lemwill/QuarkCnc/README.md

# QuarkCnc

Inspired from:
https://github.com/Expatria-Technologies/grblhal_2000_PrintNC

https://github.com/grblHAL

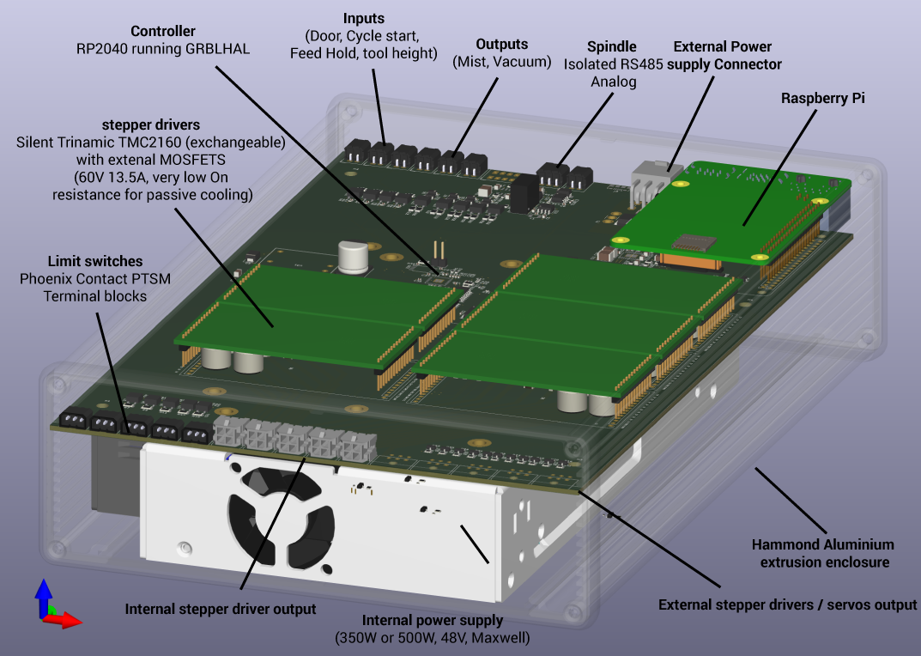
[picture p1: QuarcCnc3D.png]
3D View of QuarkCnc controller
