lemwill/QuarkCnc/QuarkCnc.pdf

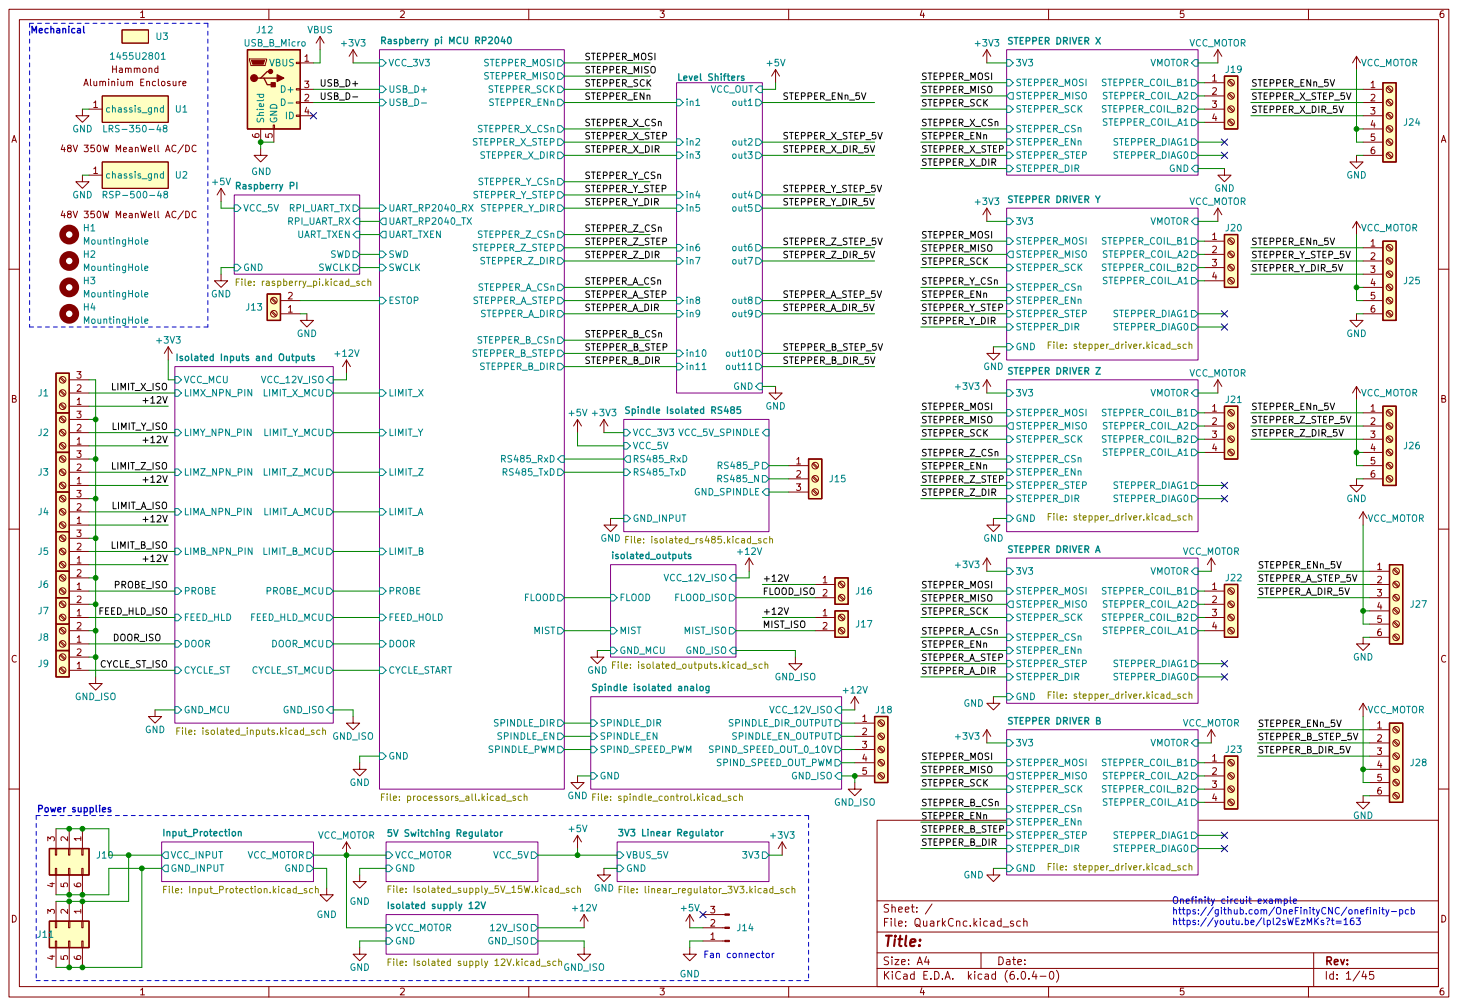
[picture p2: page 1]

Isolated Inputs and Outputs

Onefinity circuit example
https://github.com/OneFinityCNC/onefinity-pcb
https://youtu.be/lpl2sWEzMKs?t=163

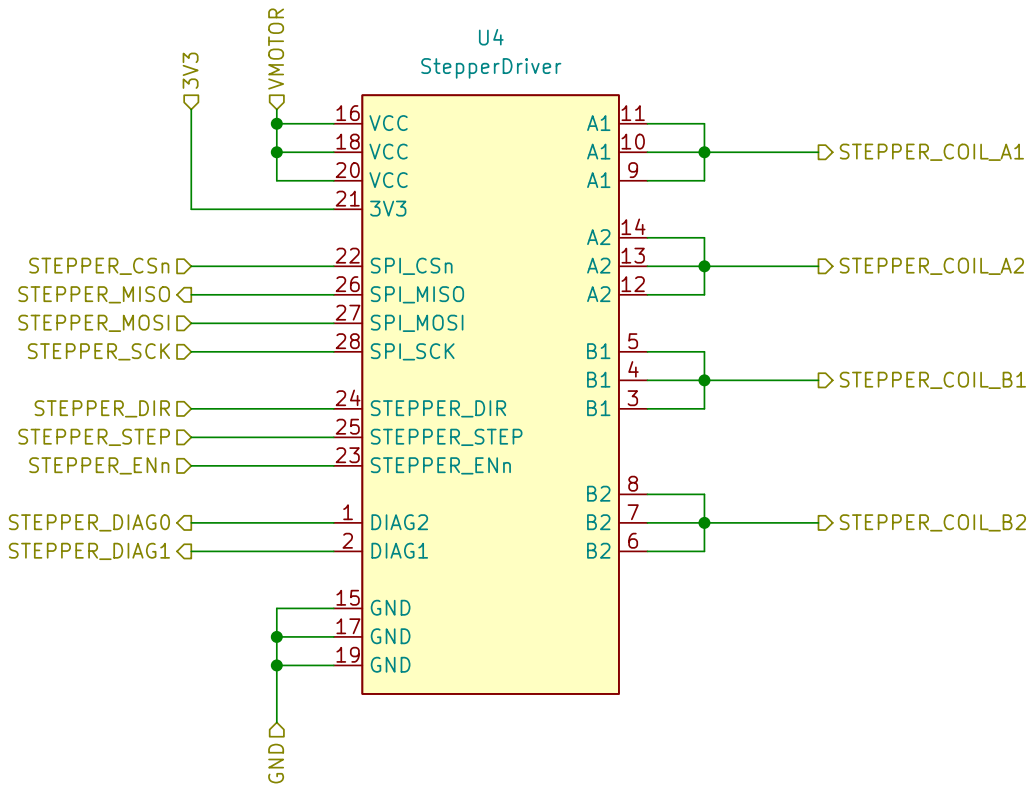
[picture p3: page 2]

File: stepper_driver.kicad_sch Sheet: /STEPPER DRIVER Y/

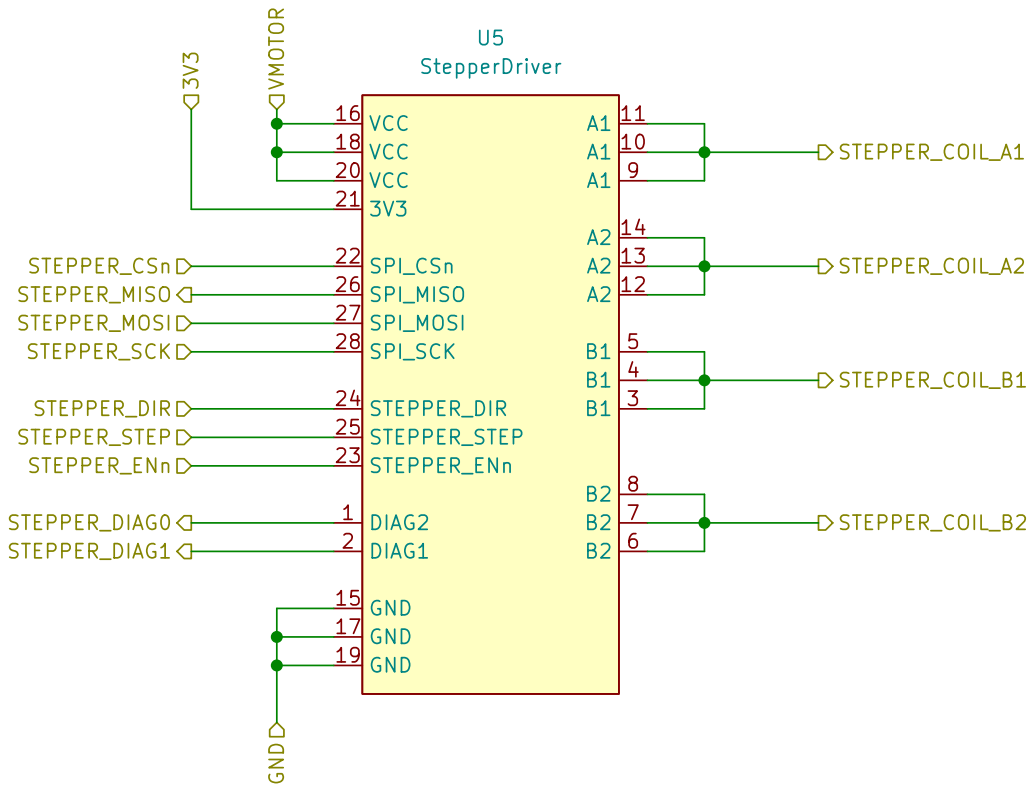
[picture p4: page 3]

File: stepper_driver.kicad_sch Sheet: /STEPPER DRIVER B/

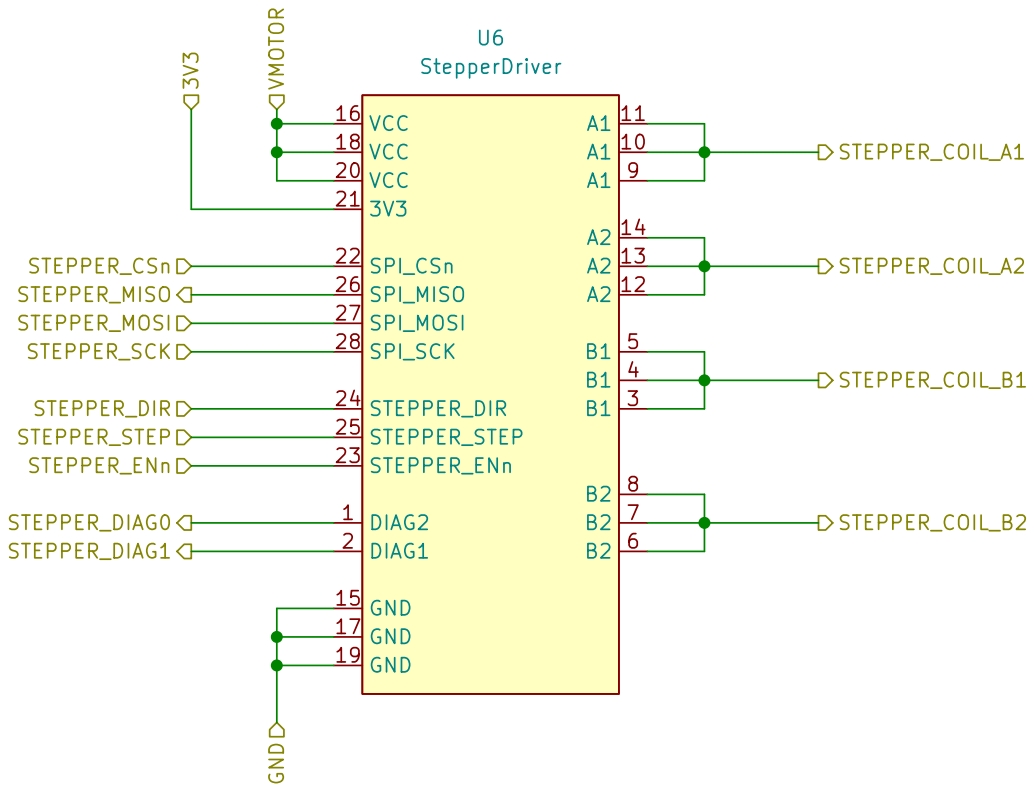
[picture p5: page 4]

File: stepper_driver.kicad_sch Sheet: /STEPPER DRIVER X/

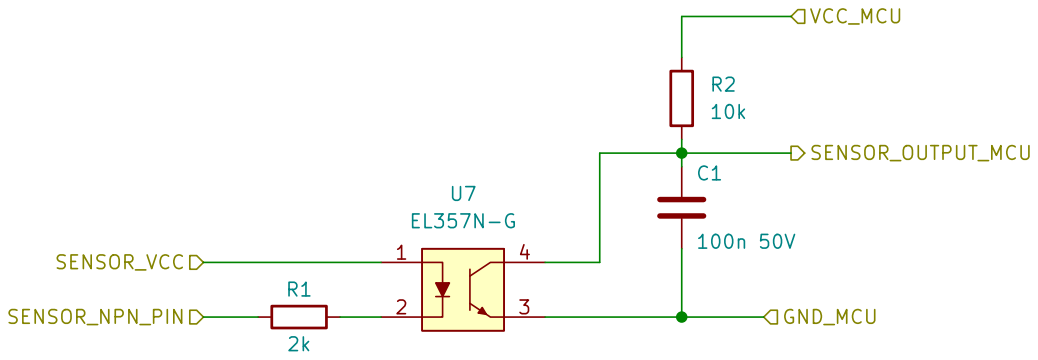
[picture p6: page 5]

Sheet: /Isolated Inputs and Outputs/LIMX/
File: isolated_input.kicad_sch
Id: 8/45 Title:

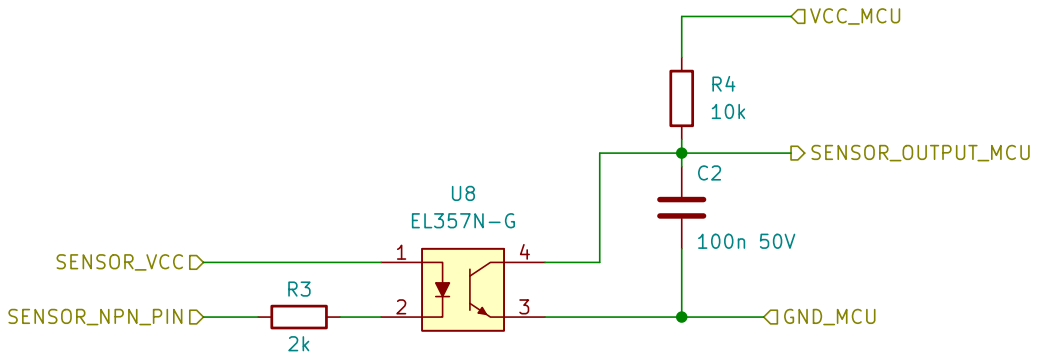
[picture p7: page 6]

Sheet: /Isolated Inputs and Outputs/LIMY/
File: isolated_input.kicad_sch
Id: 9/45 Title:

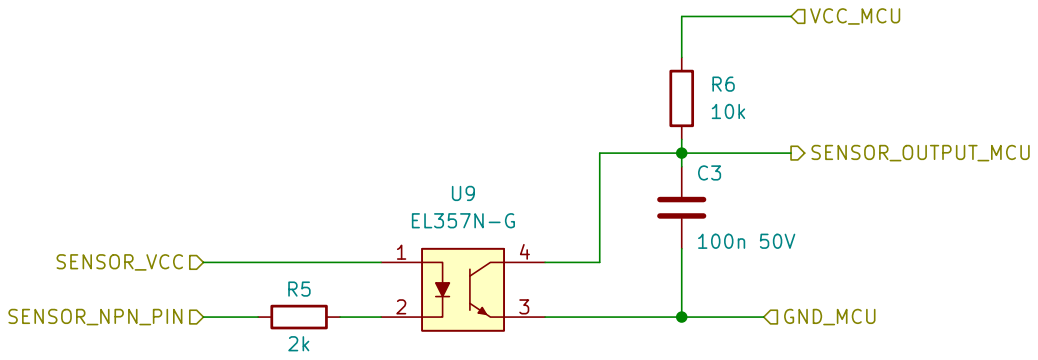
[picture p8: page 7]

Sheet: /Isolated Inputs and Outputs/LIMZ/
File: isolated_input.kicad_sch
Id: 10/45 Title:

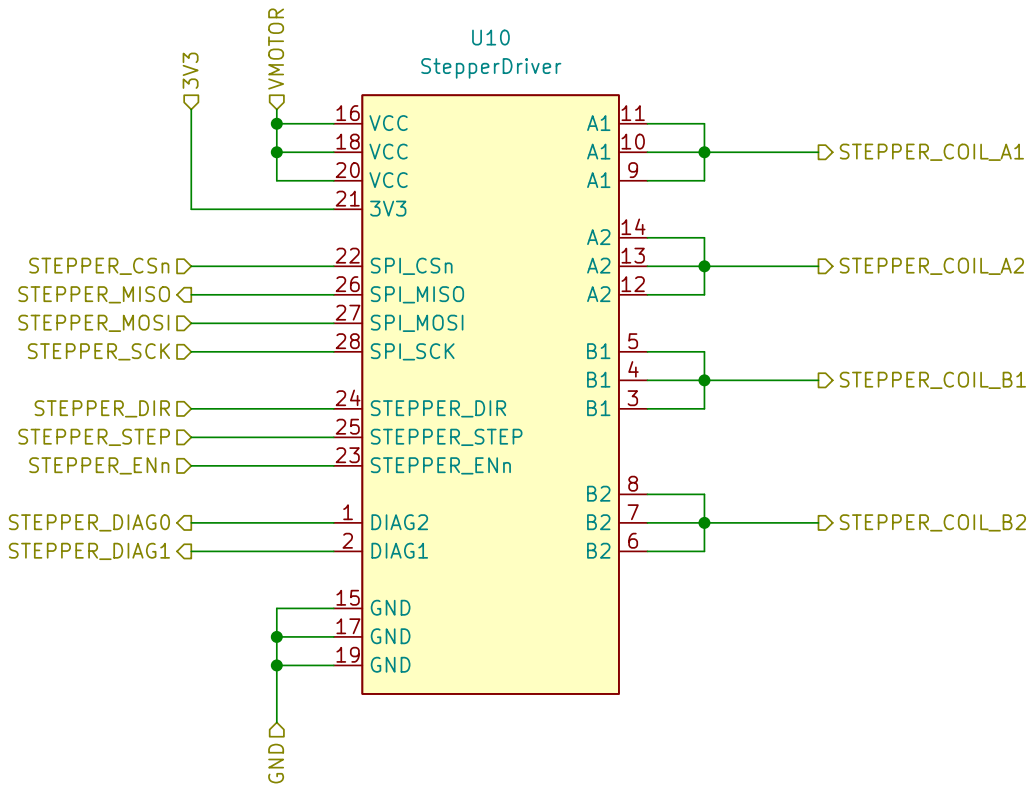
[picture p9: page 8]

File: stepper_driver.kicad_sch Sheet: /STEPPER DRIVER Z/

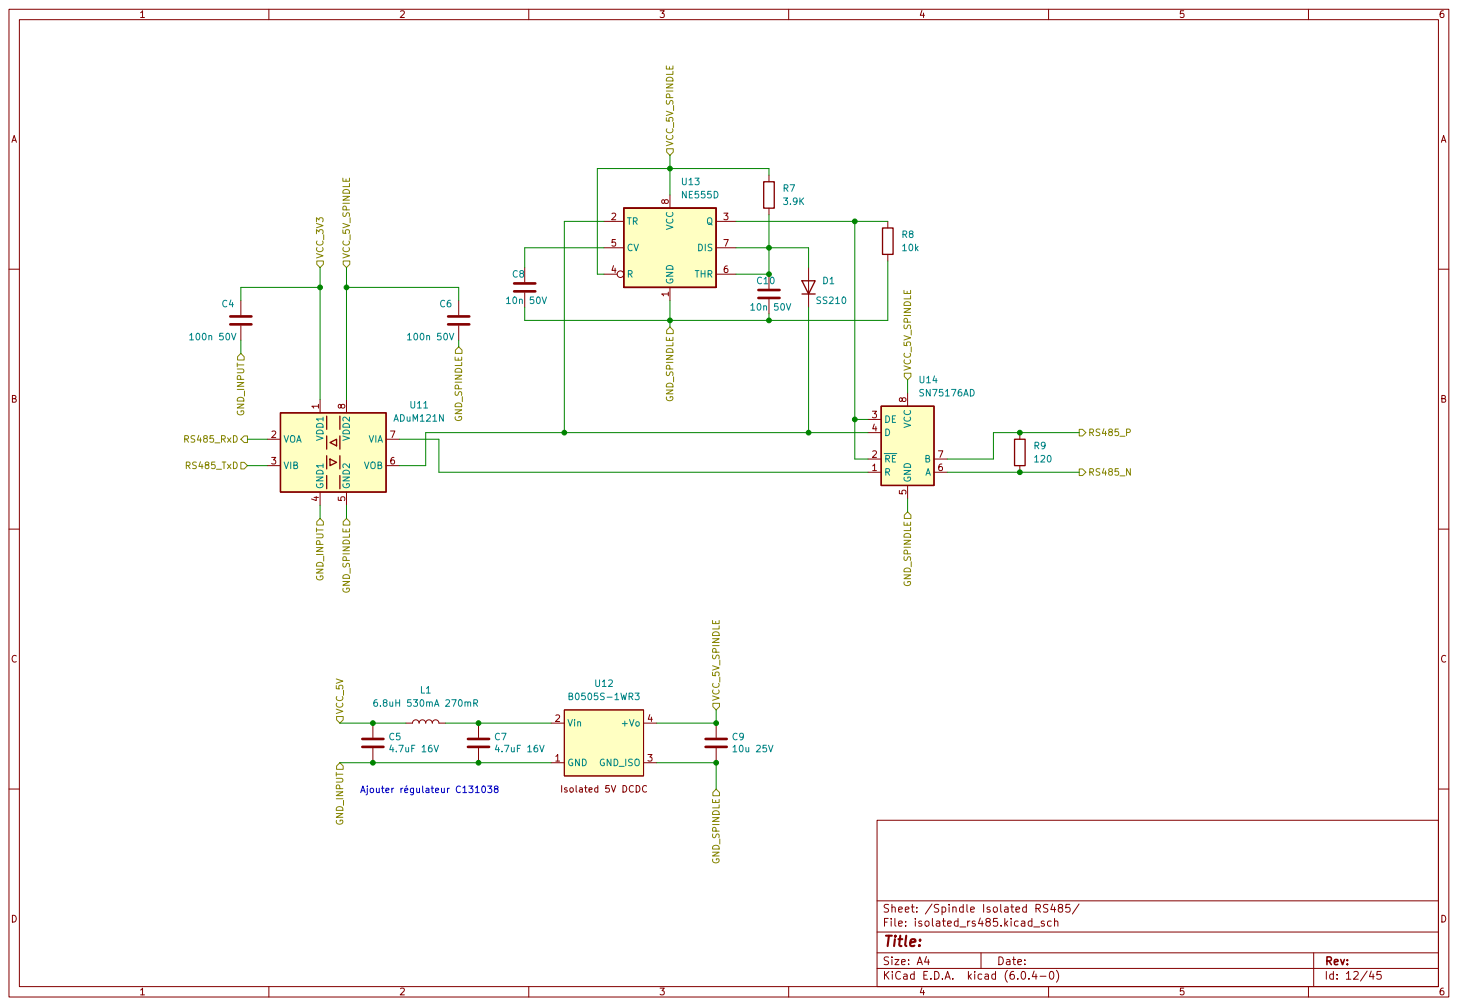
[picture p10: page 9]

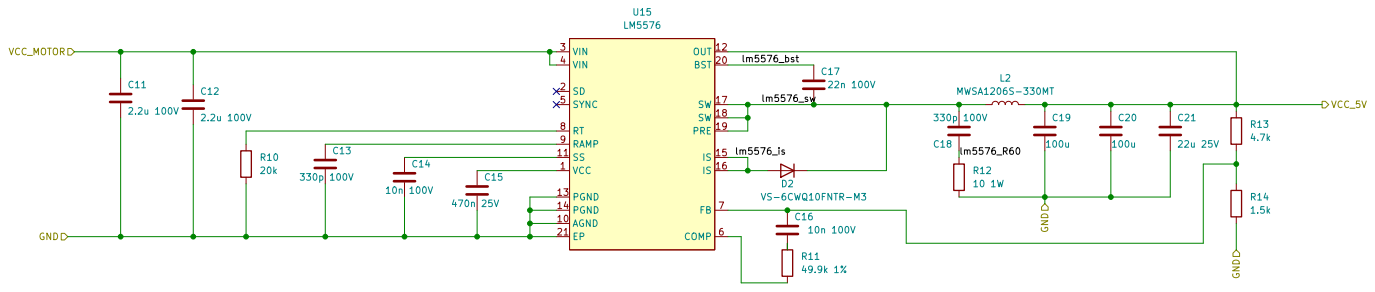
[picture p11: page 10]

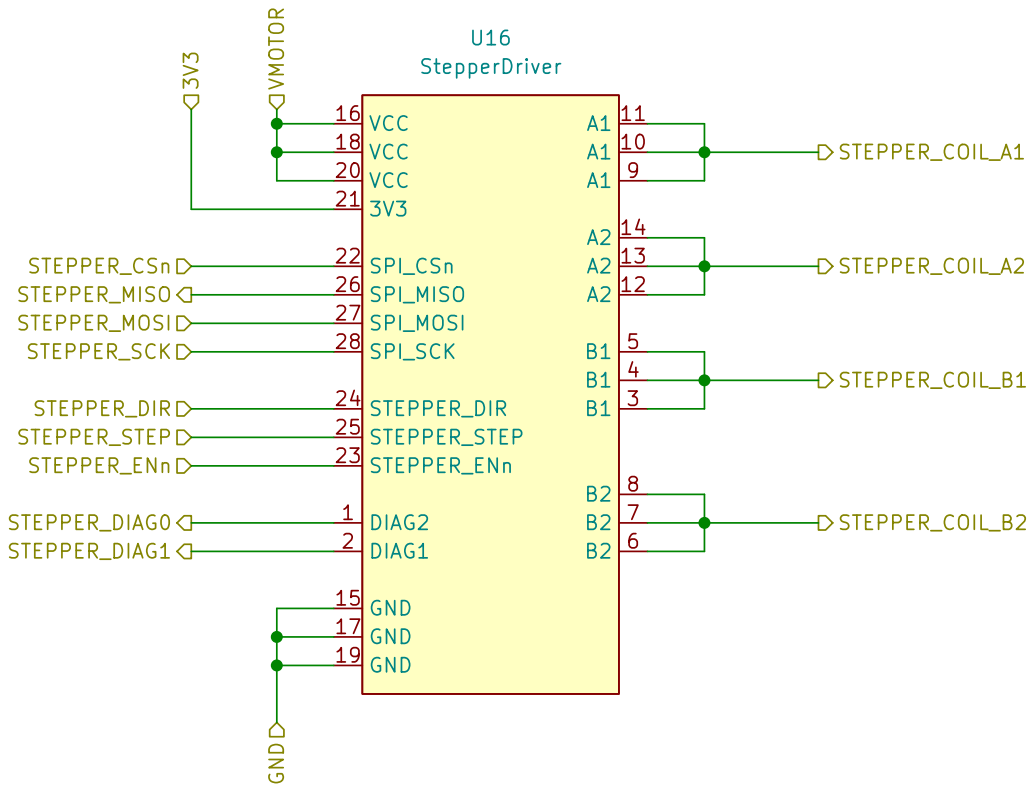
[picture p12: page 11]

File: stepper_driver.kicad_sch Sheet: /STEPPER DRIVER A/

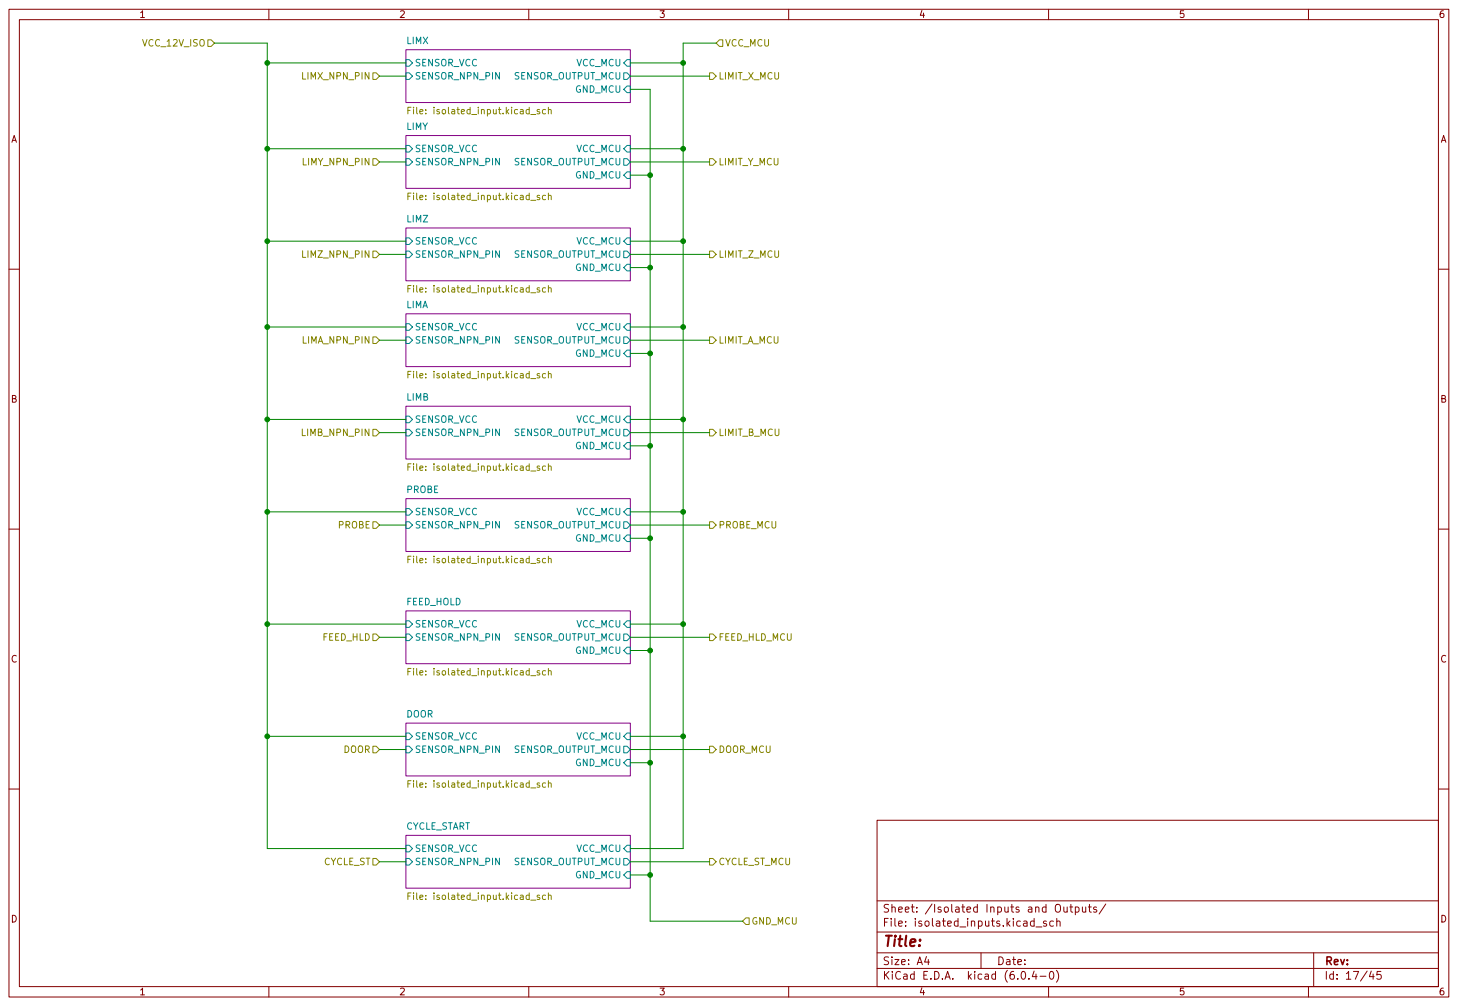
[picture p13: page 12]

DOOR
Sheet: /Isolated Inputs and Outputs/ SENSOR_VCC

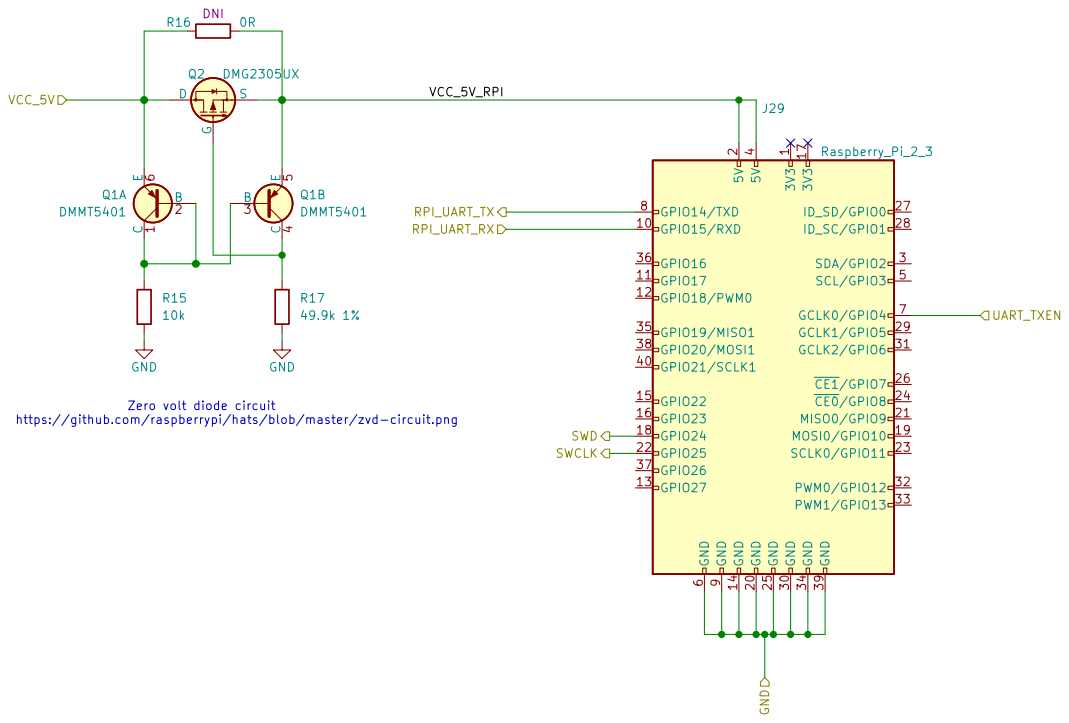
[picture p14: page 13]

VCC_5V_RPI Zero volt diode circuit https://github.com/raspberrypi/hats/blob/master/zvd-circuit.png

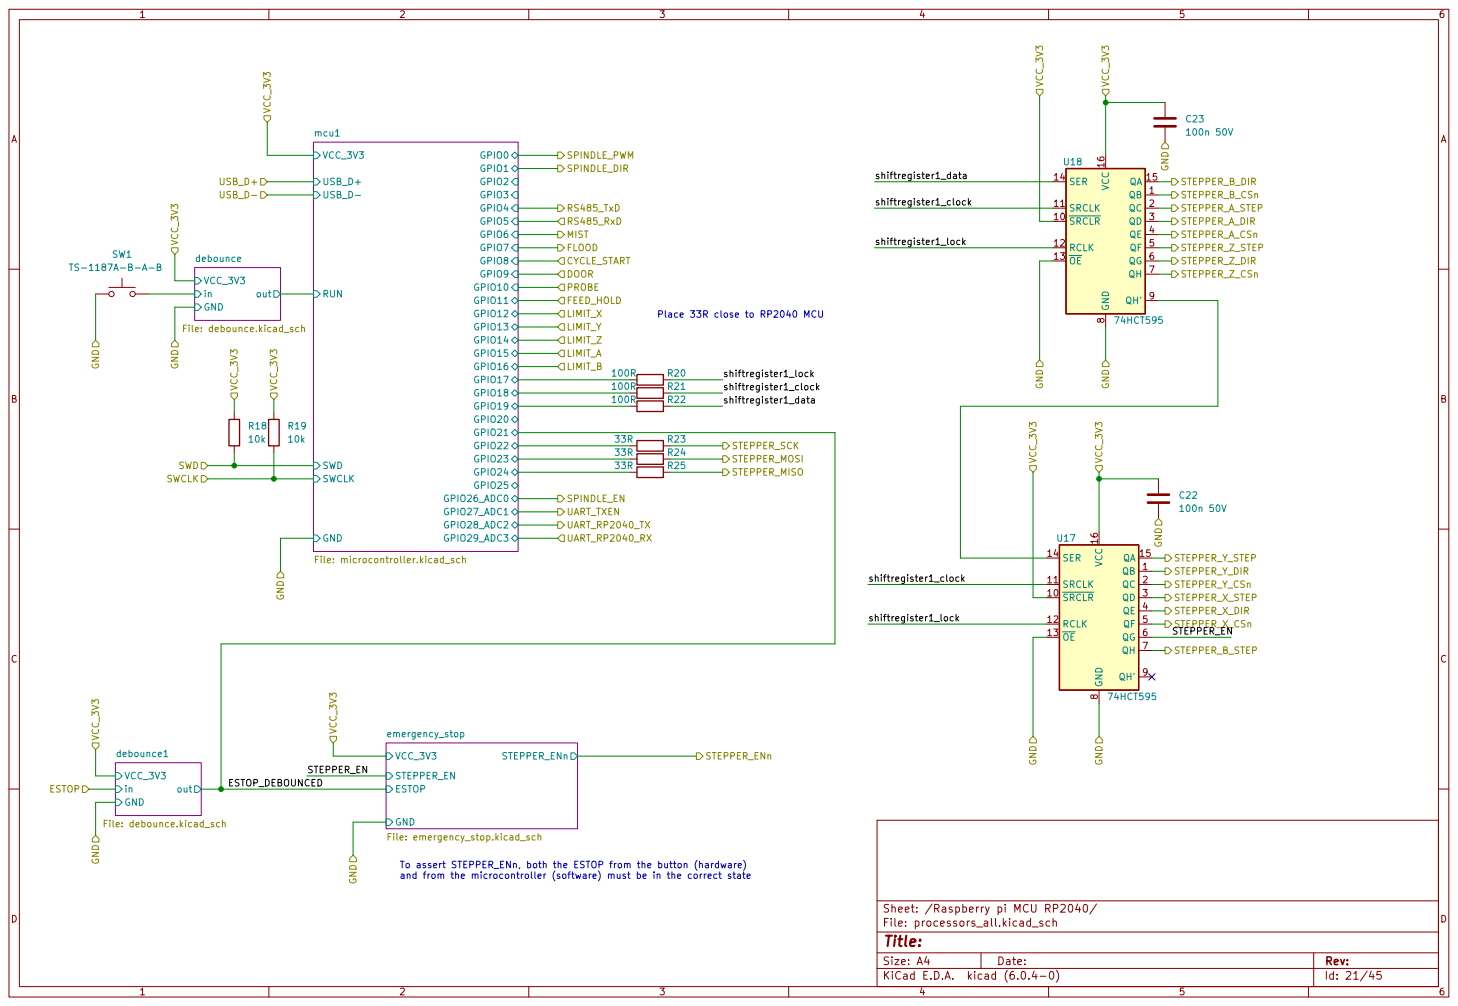
[picture p15: page 14]

Place 33R close to RP2040 MCU

To assert STEPPER_ENn, both the ESTOP from the button (hardware)
and from the microcontroller (software) must be in the correct state

Sheet: /Raspberry pi MCU RP2040/
File: processors_all.kicad_sch
Id: 21/45 Title:

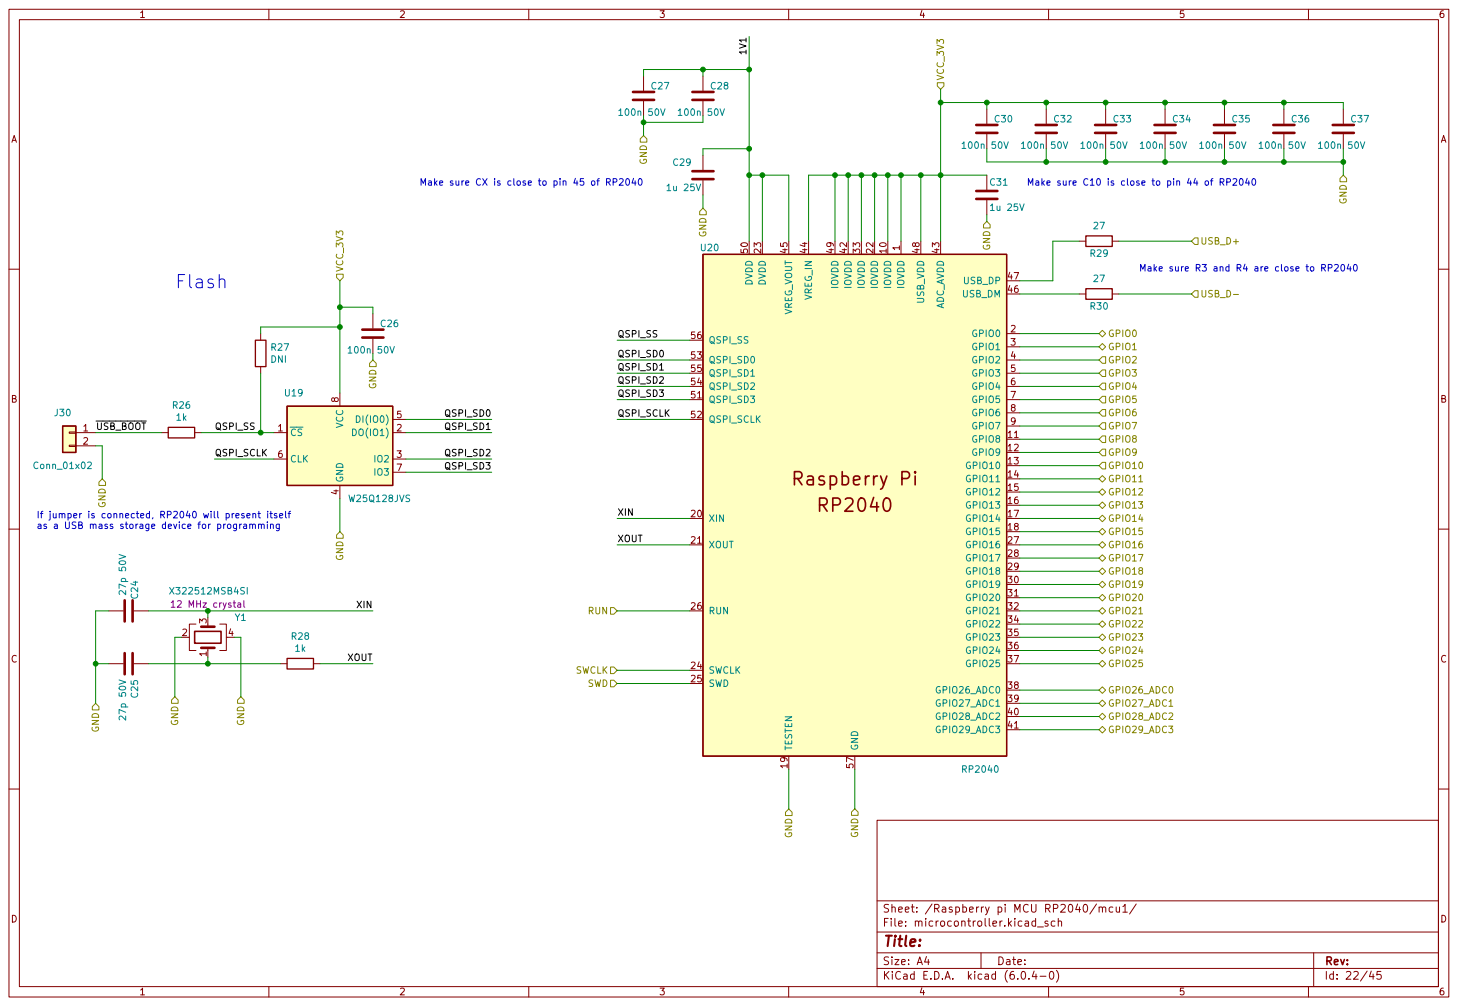
[picture p16: page 15]

1 IOVDD 10 GPIO8 11 GPIO9 12 GPIO10 13 GPIO11 14 GPIO12 15 GPIO13 16 GPIO14 17 GPIO15 18 TESTEN 19 GPIO0 2 XIN 20 XOUT 21 IOVDD 22 DVDD 23 SWCLK 24 SWD 25 RUN 26 GPIO16 27 GPIO17 28 GPIO18 29 GPIO1 3 GPIO19 30 GPIO20 31 GPIO21 32 IOVDD 33 GPIO22 34 GPIO23 35 GPIO24 36 GPIO25 37 GPIO26_ADC0 38 GPIO27_ADC1 39 GPIO2 4 GPIO28_ADC2 40 GPIO29_ADC3 41 IOVDD 42 ADC_AVDD 43 VREG_IN 44 VREG_VOUT 45 USB_DM 46 USB_DP 47 USB_VDD 48 IOVDD 49 GPIO3 5 DVDD 50 QSPI_SD3 51 QSPI_SCLK 52 QSPI_SD0 53 QSPI_SD2 54 QSPI_SD1 55 QSPI_SS 56 GND 57 GPIO4 6 GPIO5 7 GPIO6 8 GPIO7 9 U20 RP2040

If jumper is connected, RP2040 will present itself
as a USB mass storage device for programming

Sheet: /Raspberry pi MCU RP2040/mcu1/
File: microcontroller.kicad_sch
Id: 22/45 Title:

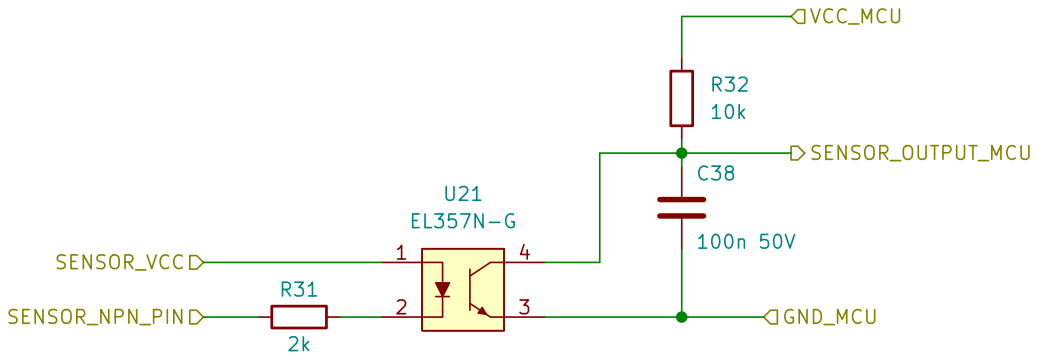
[picture p17: page 16]

Sheet: /Isolated Inputs and Outputs/LIMA/
File: isolated_input.kicad_sch
Id: 25/45 Title:

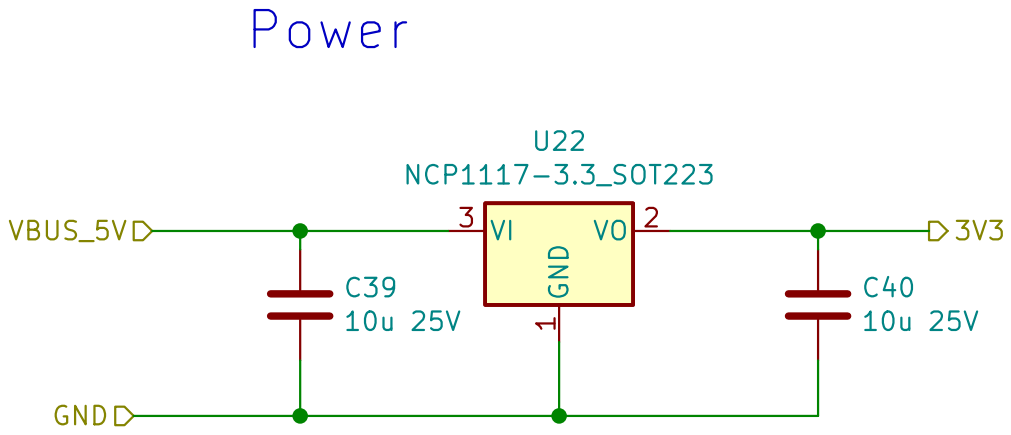
[picture p18: page 17]

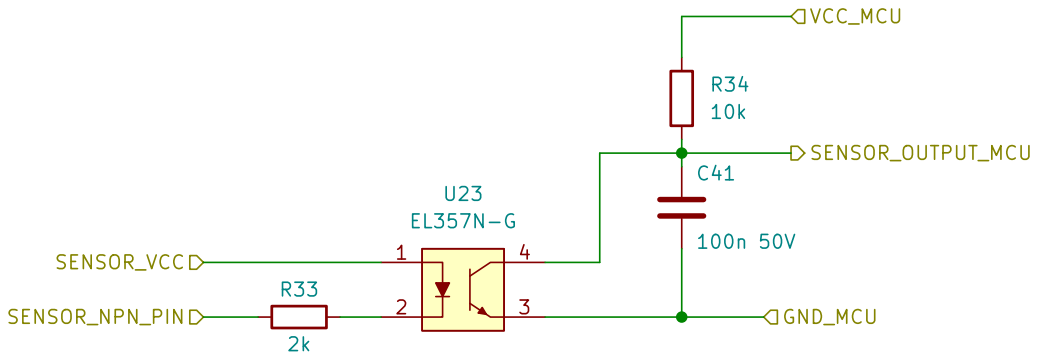
[picture p19: page 18]

Sheet: /Isolated Inputs and Outputs/LIMB/
File: isolated_input.kicad_sch
Id: 27/45 Title:

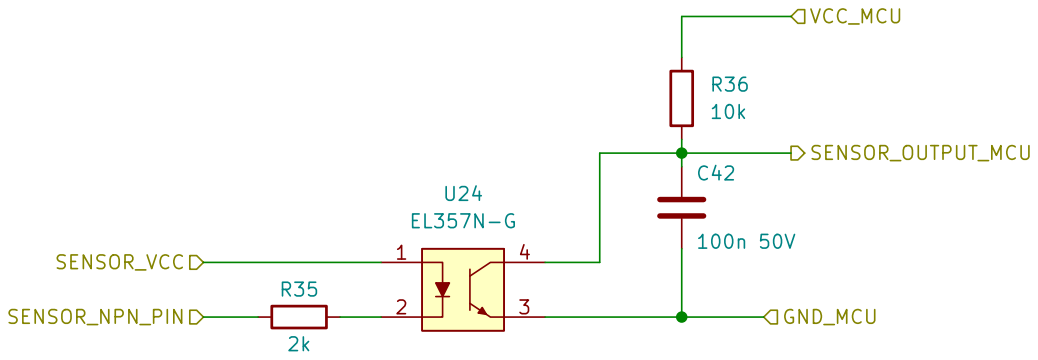
[picture p20: page 19]

Sheet: /Isolated Inputs and Outputs/PROBE/
File: isolated_input.kicad_sch
Id: 27/45 Title:

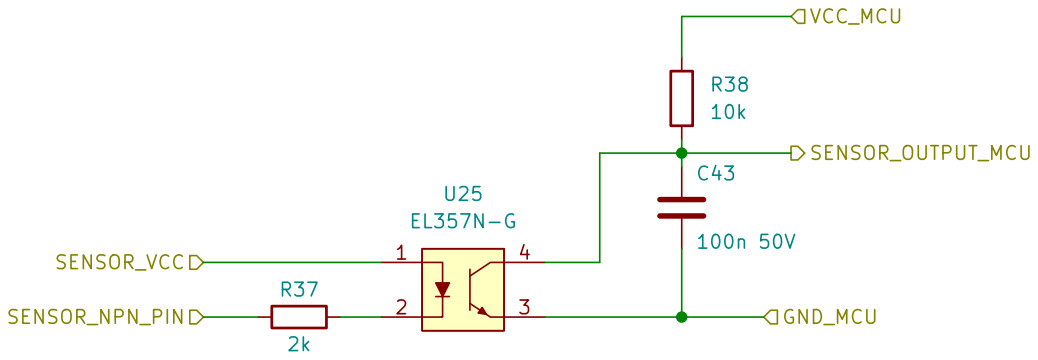
[picture p21: page 20]

Sheet: /Isolated Inputs and Outputs/FEED_HOLD/
File: isolated_input.kicad_sch
Id: 28/45 Title:

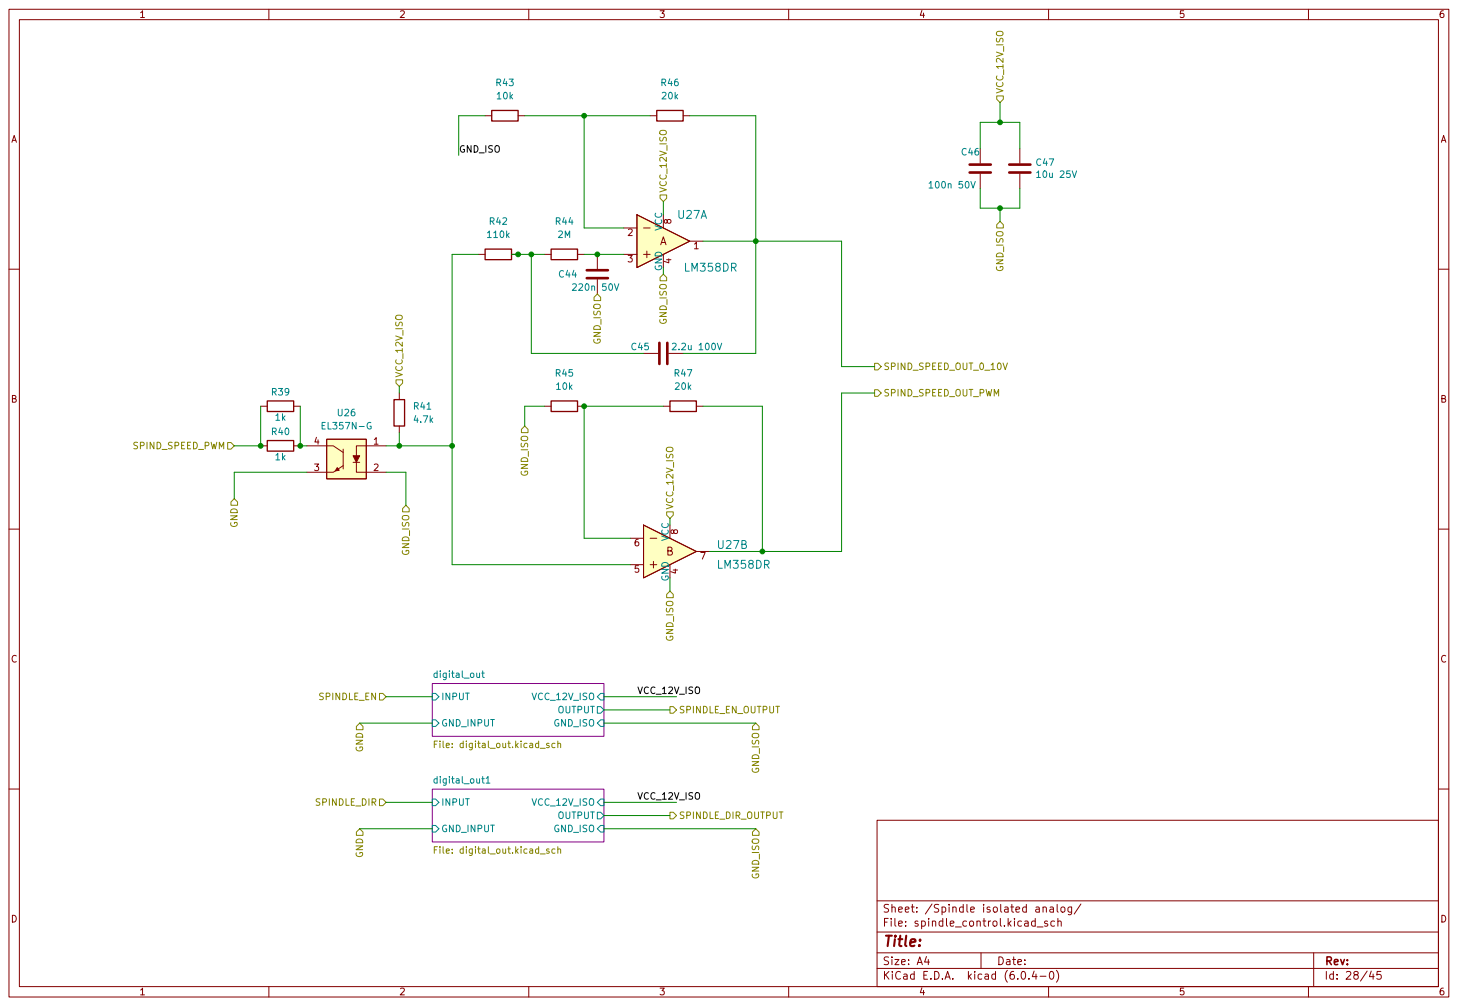
[picture p22: page 21]

OUTPUT
Sheet: /Spindle isolated analog/ GND_ISO

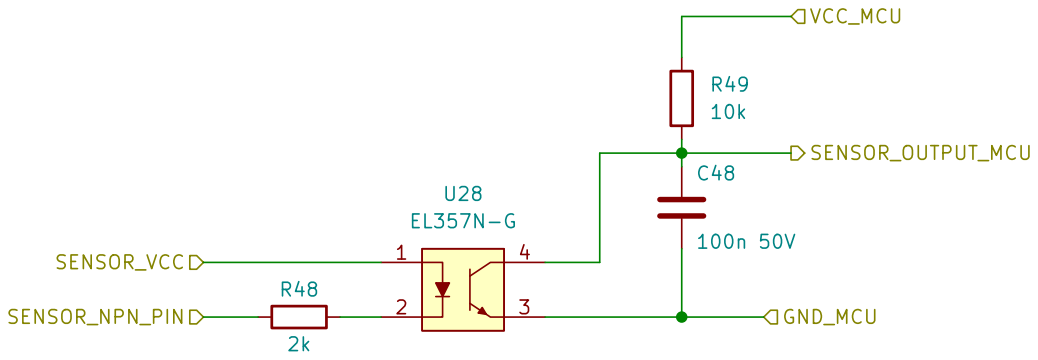
[picture p23: page 22]

Sheet: /Isolated Inputs and Outputs/DOOR/
File: isolated_input.kicad_sch
Id: 29/45 Title:

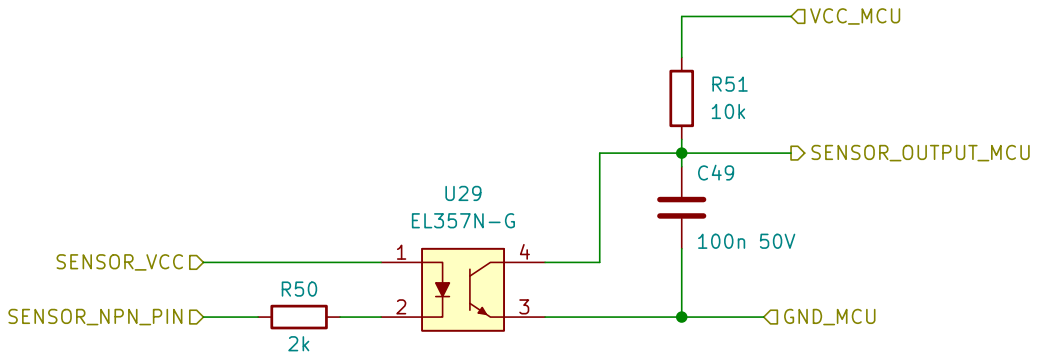
[picture p24: page 23]

Sheet: /Isolated Inputs and Outputs/CYCLE_START/
File: isolated_input.kicad_sch
Id: 30/45 Title:

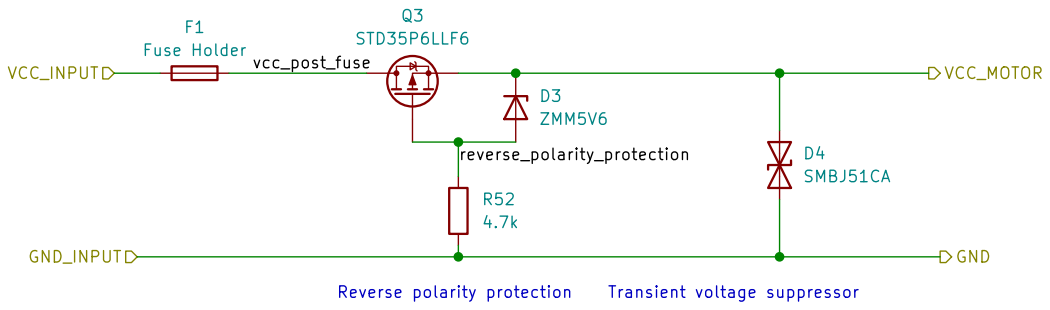
[picture p25: page 24]

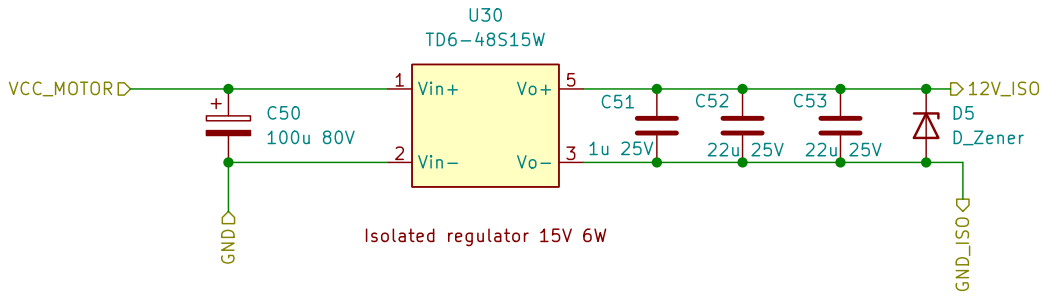
[picture p26: page 25]

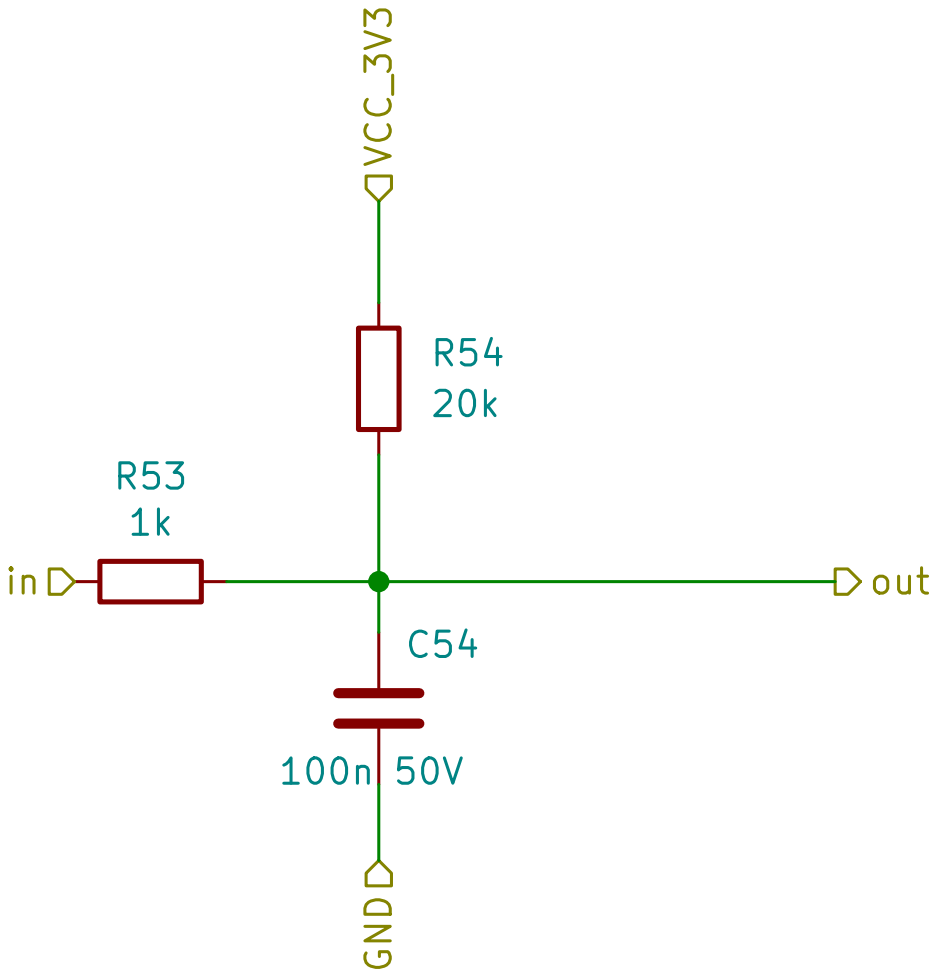
[picture p27: page 26]

Sheet: /Raspberry pi MCU RP2040/debounce1/ C54

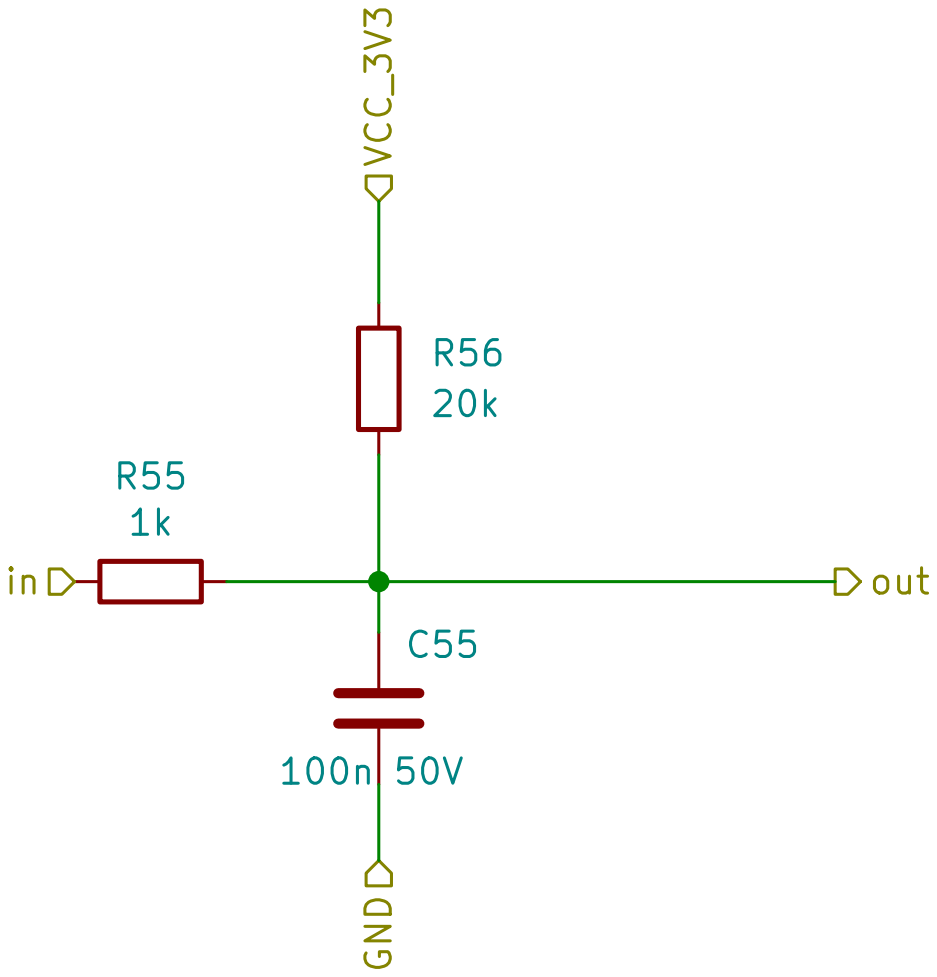
[picture p28: page 27]

Sheet: /Raspberry pi MCU RP2040/debounce/ C55

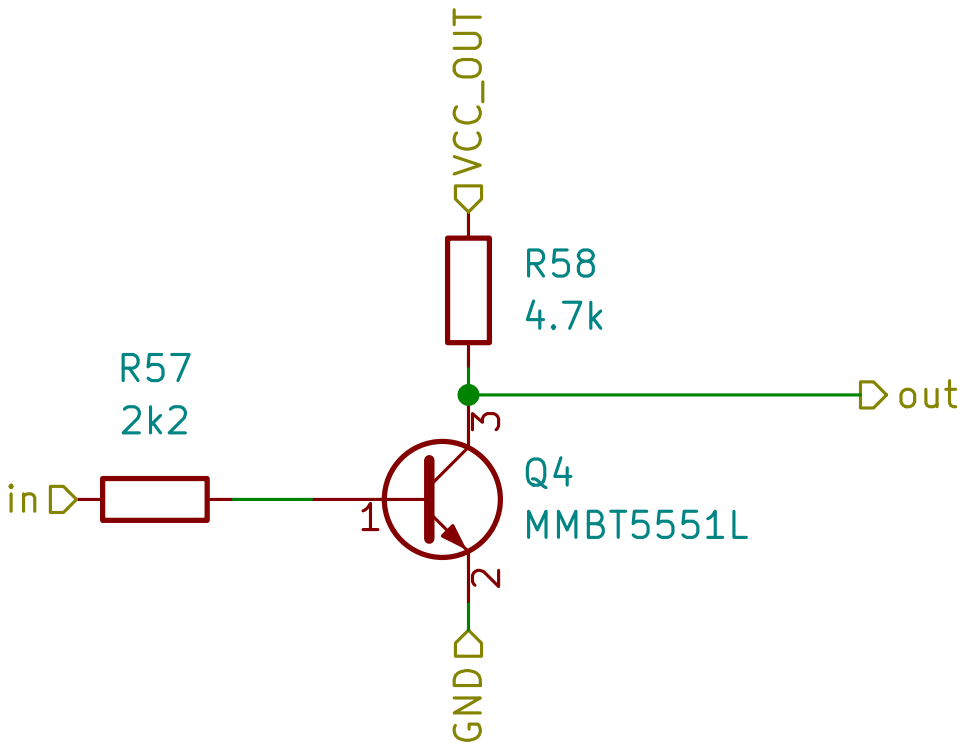
[picture p29: page 28]

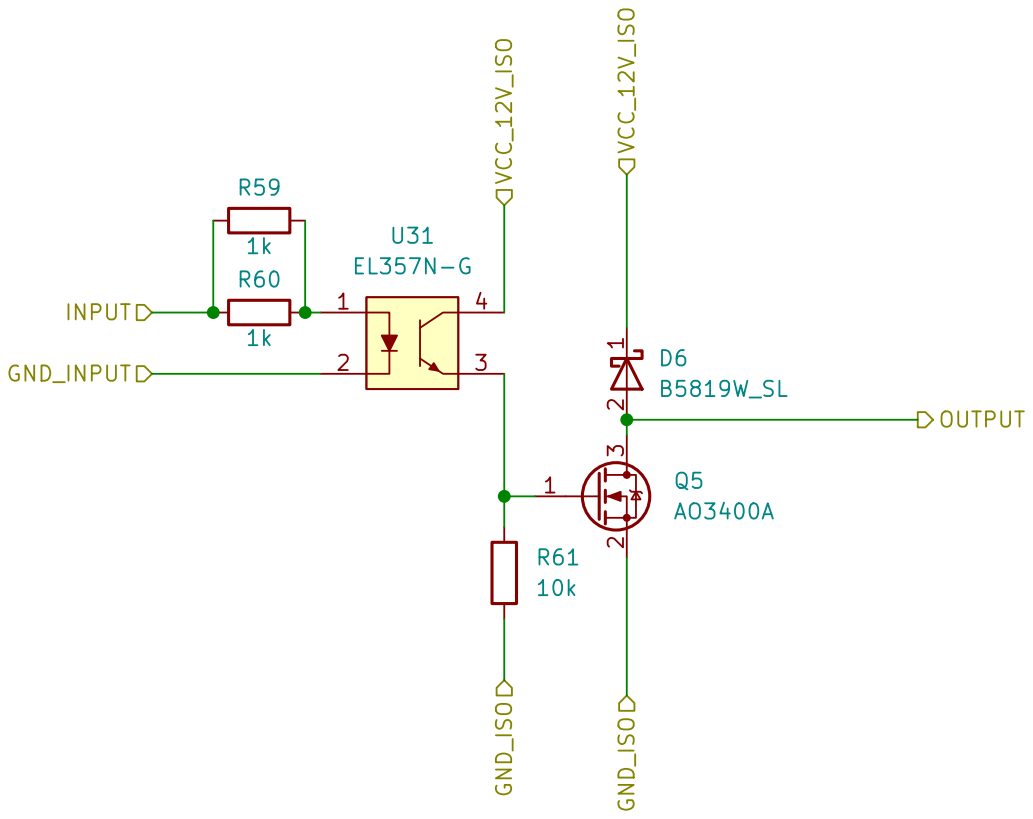
[picture p30: page 29]

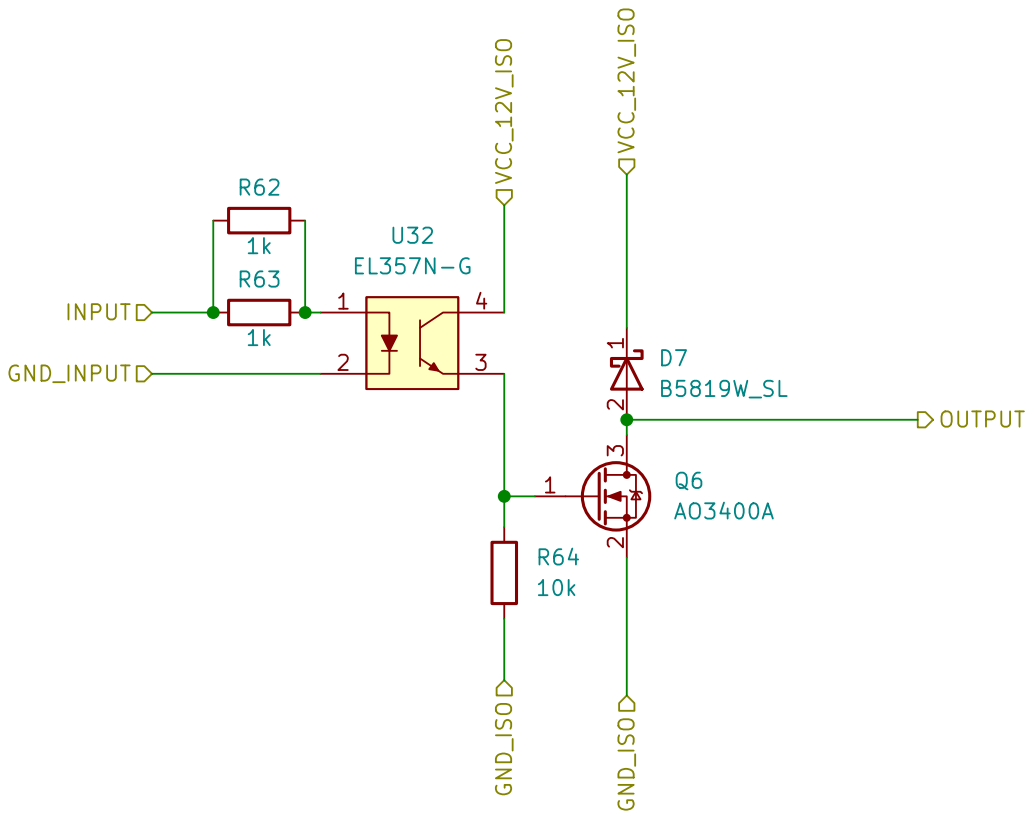
[picture p31: page 30]

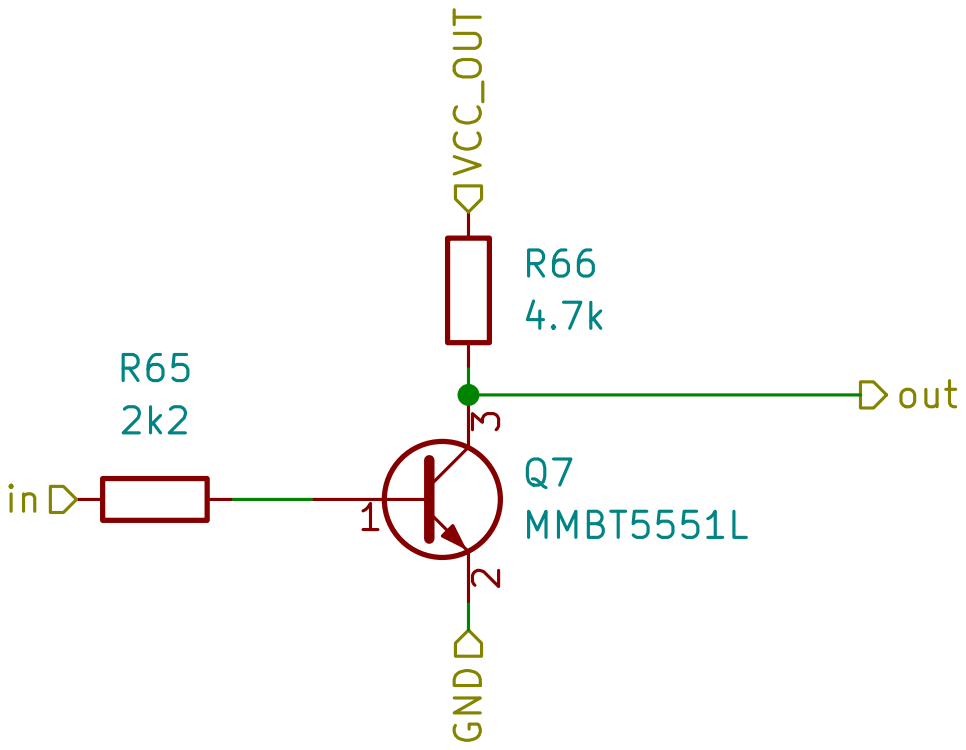
[picture p32: page 31]

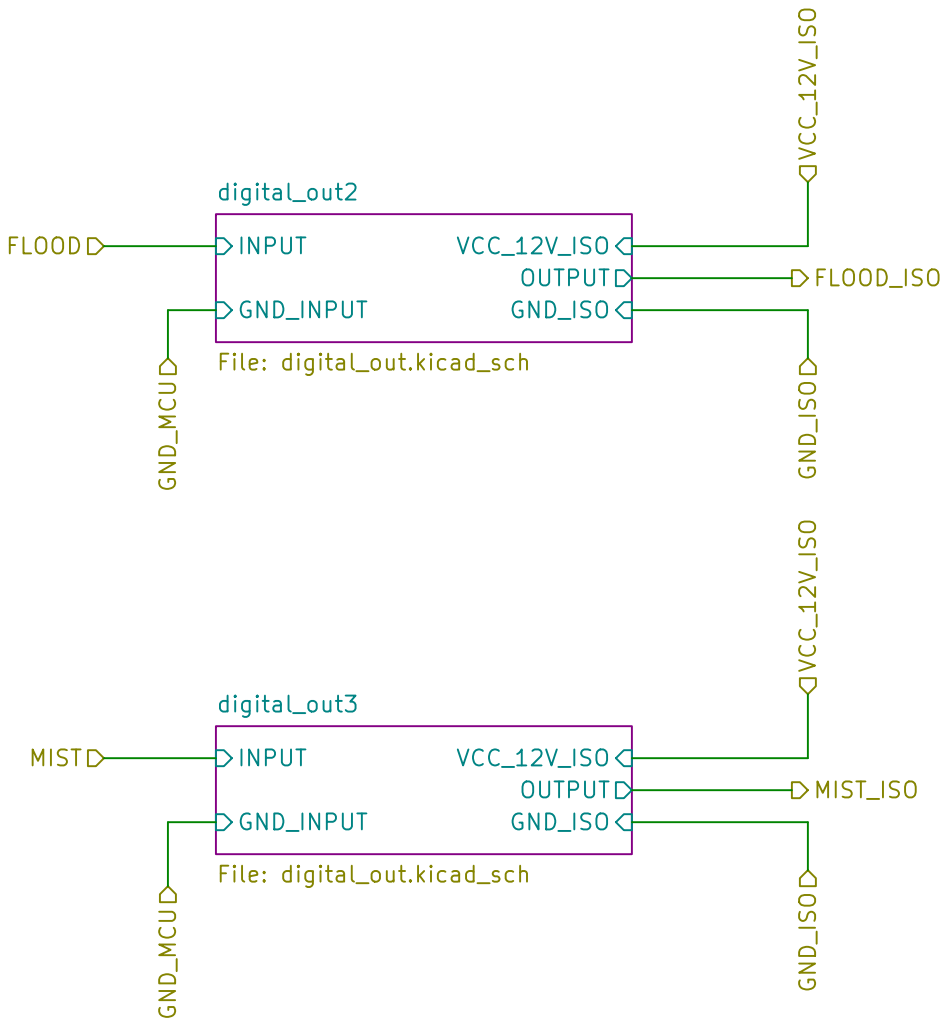
[picture p33: page 32]

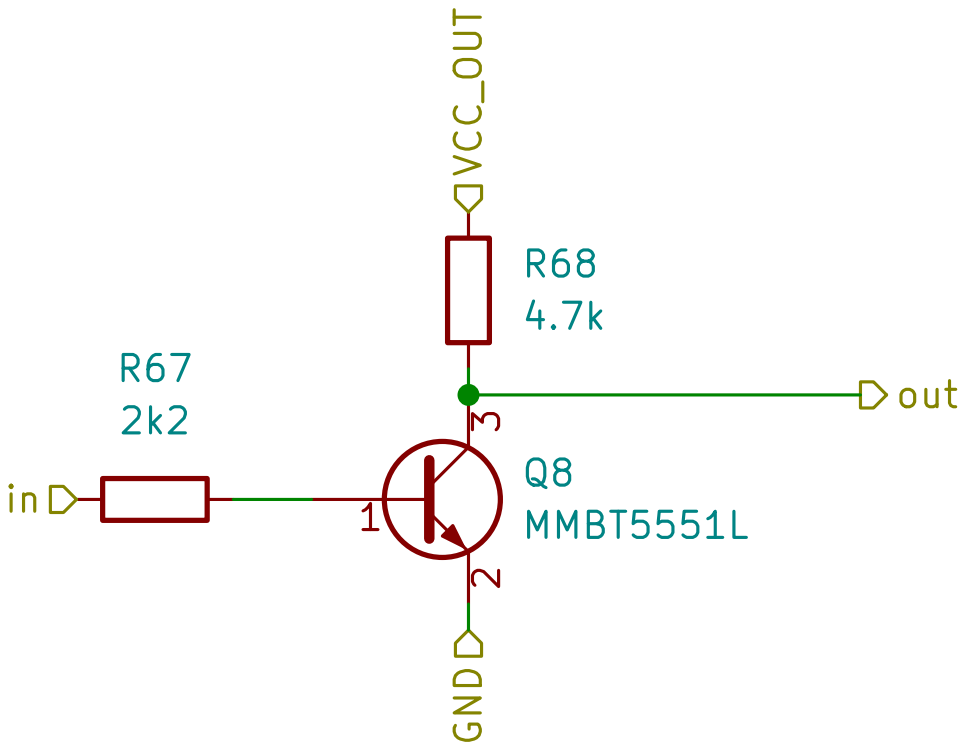
[picture p34: page 33]

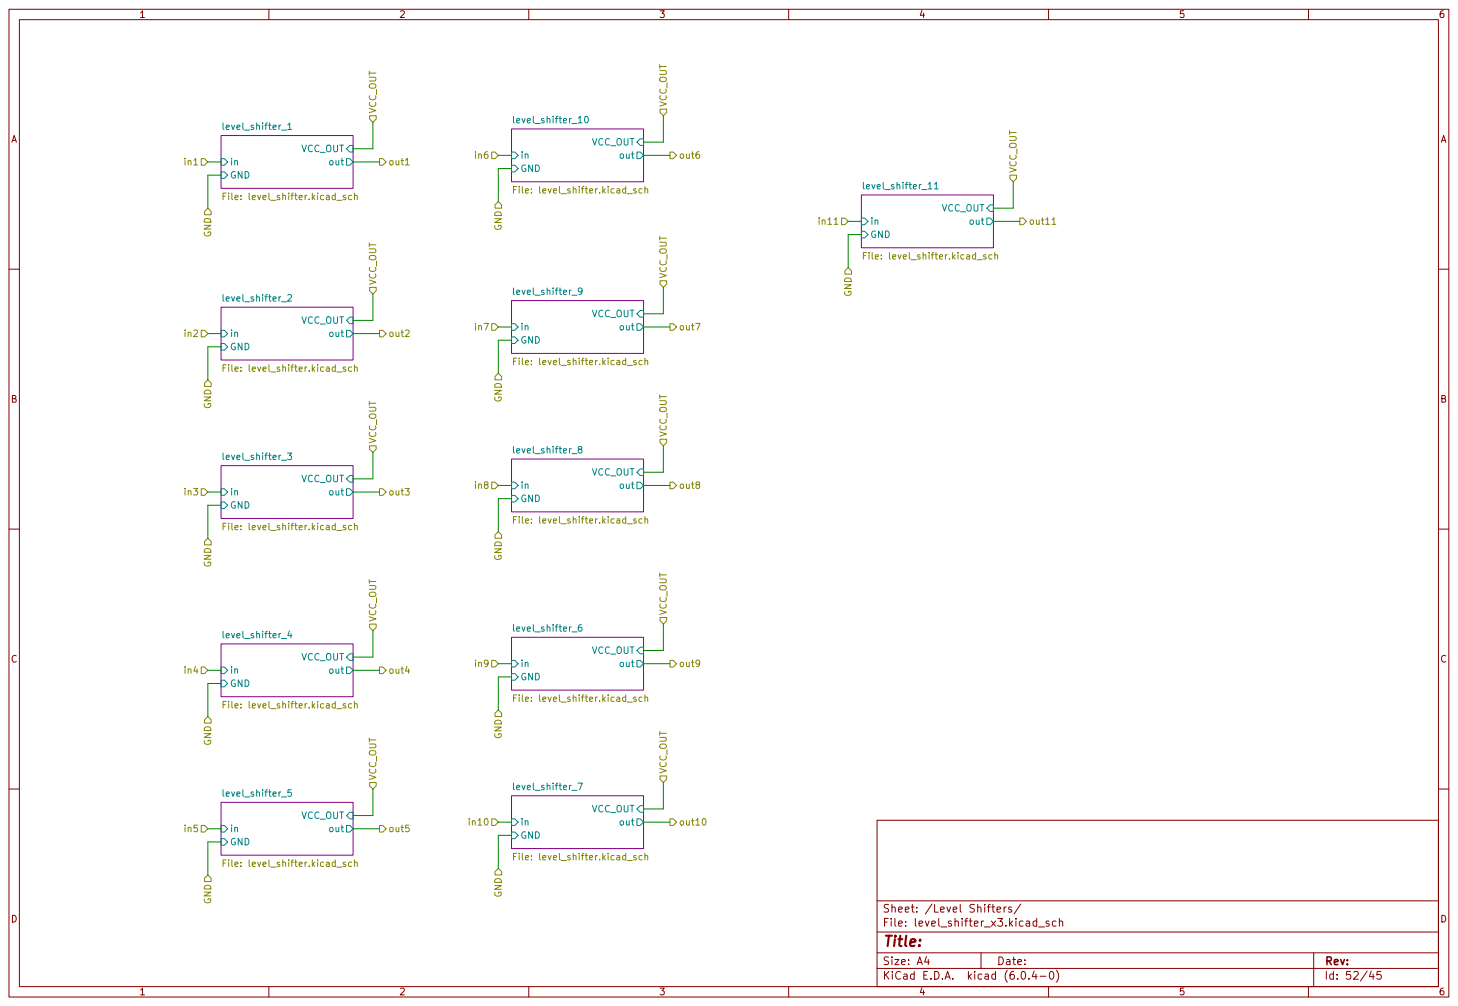
[picture p35: page 34]

File: level_shifter_x3.kicad_sch Sheet: /Level Shifters/ GND

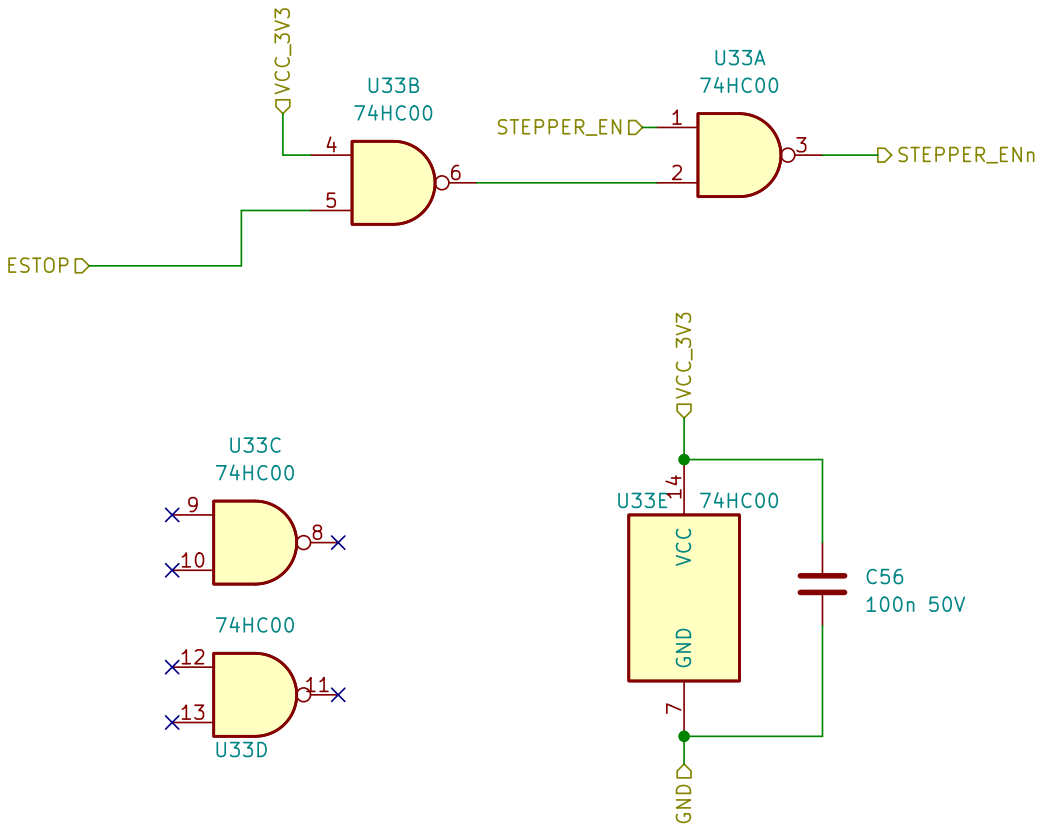
[picture p36: page 35]

Sheet: /Raspberry pi MCU RP2040/emergency_stop/ C56

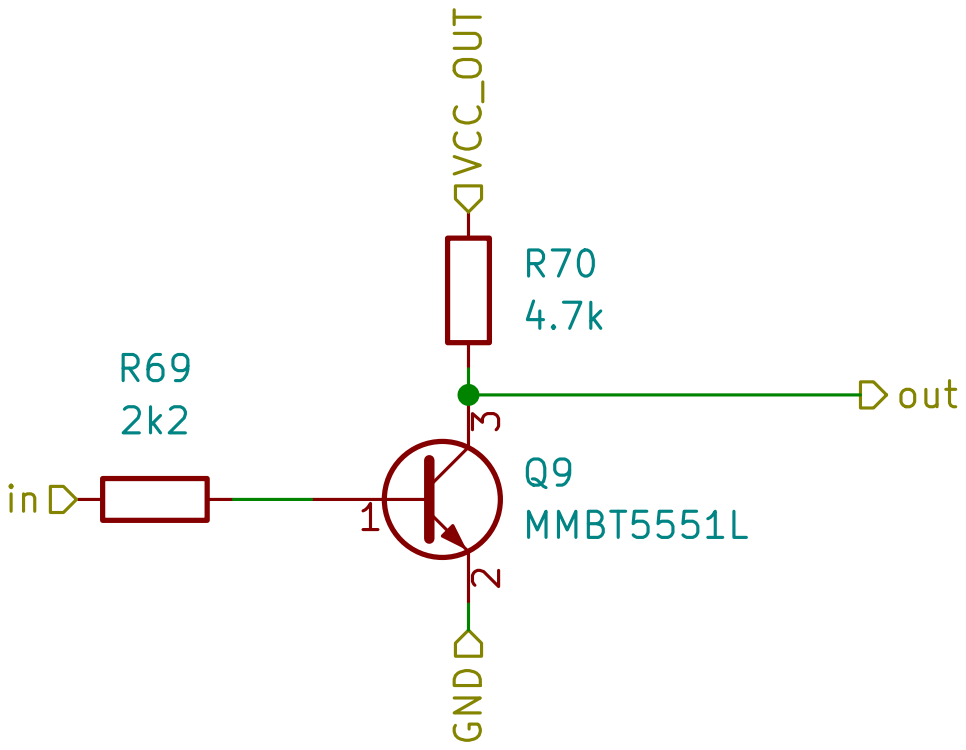
[picture p37: page 36]

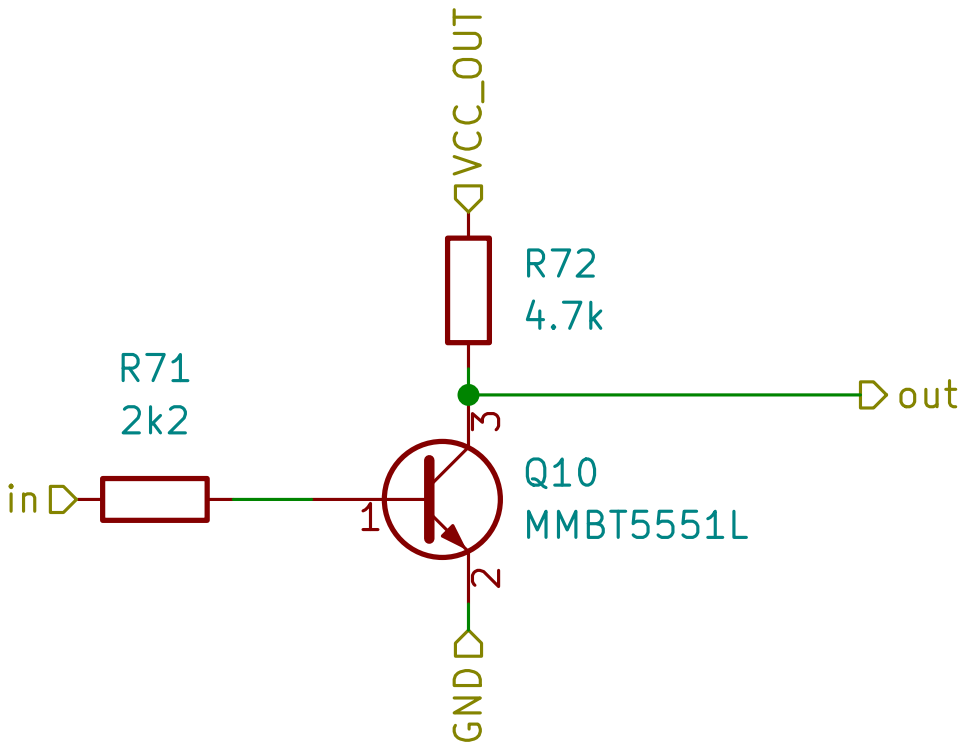
[picture p38: page 37]

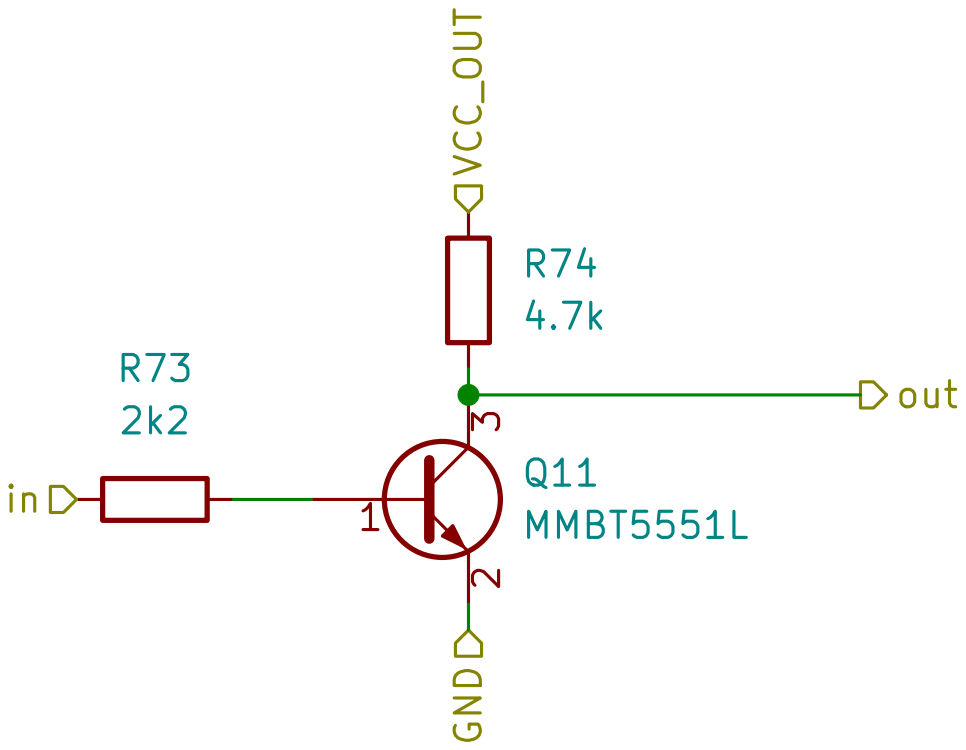
[picture p39: page 38]

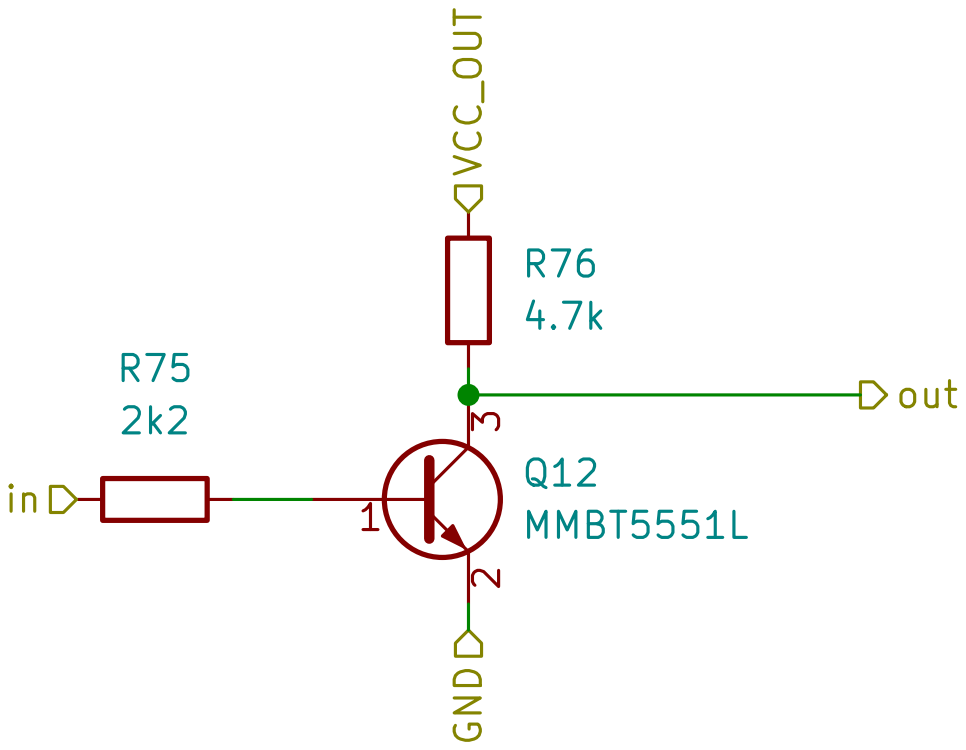
[picture p40: page 39]

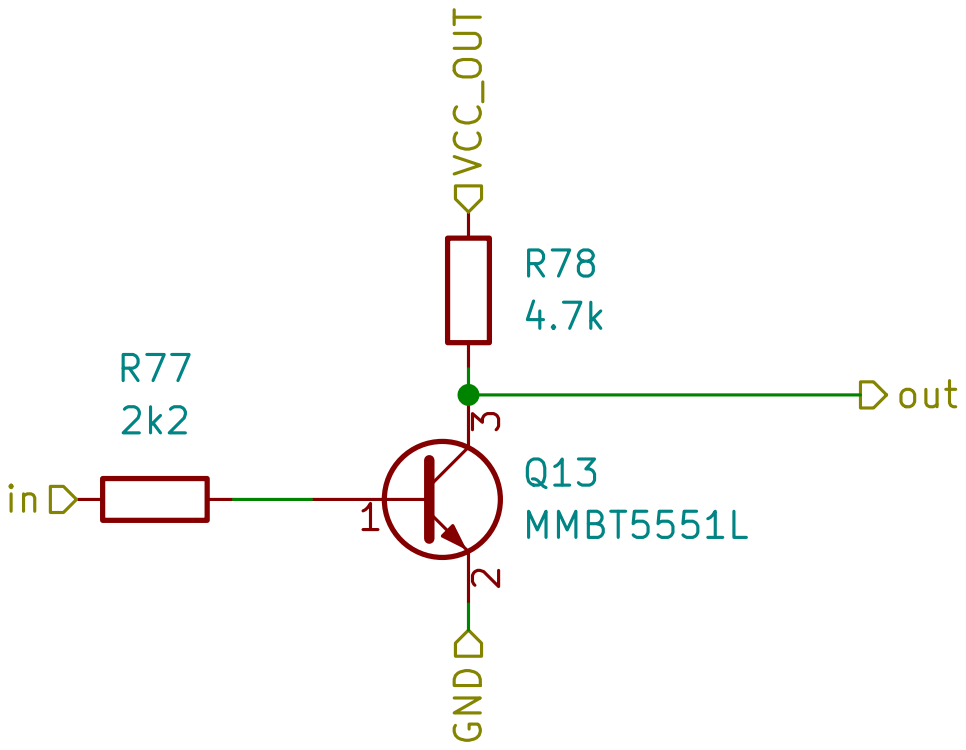
[picture p41: page 40]

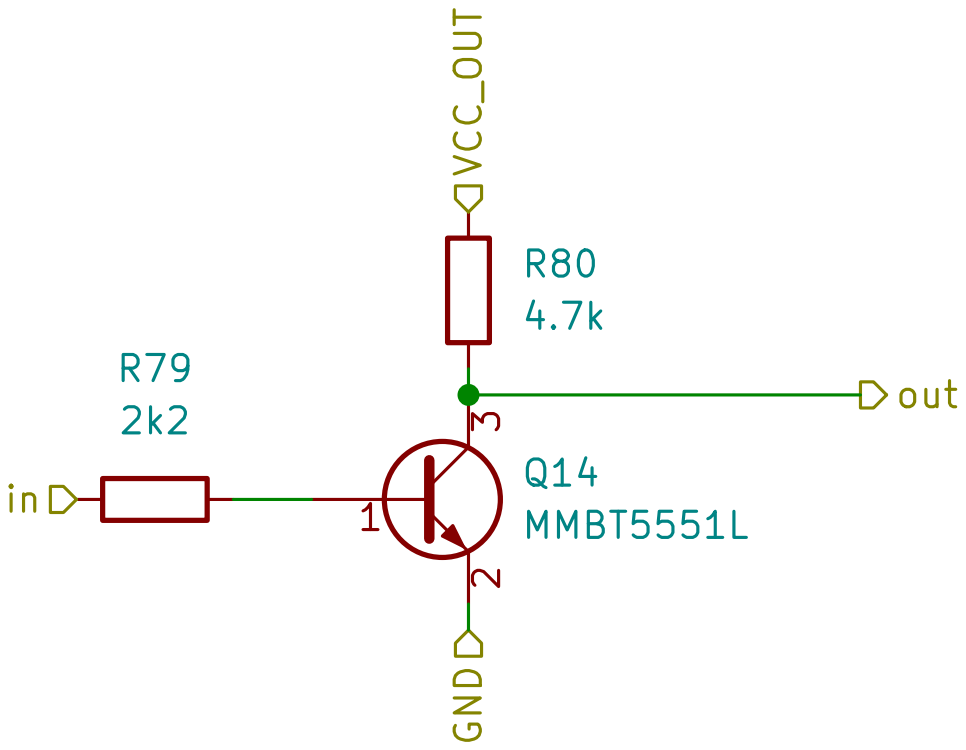
[picture p42: page 41]

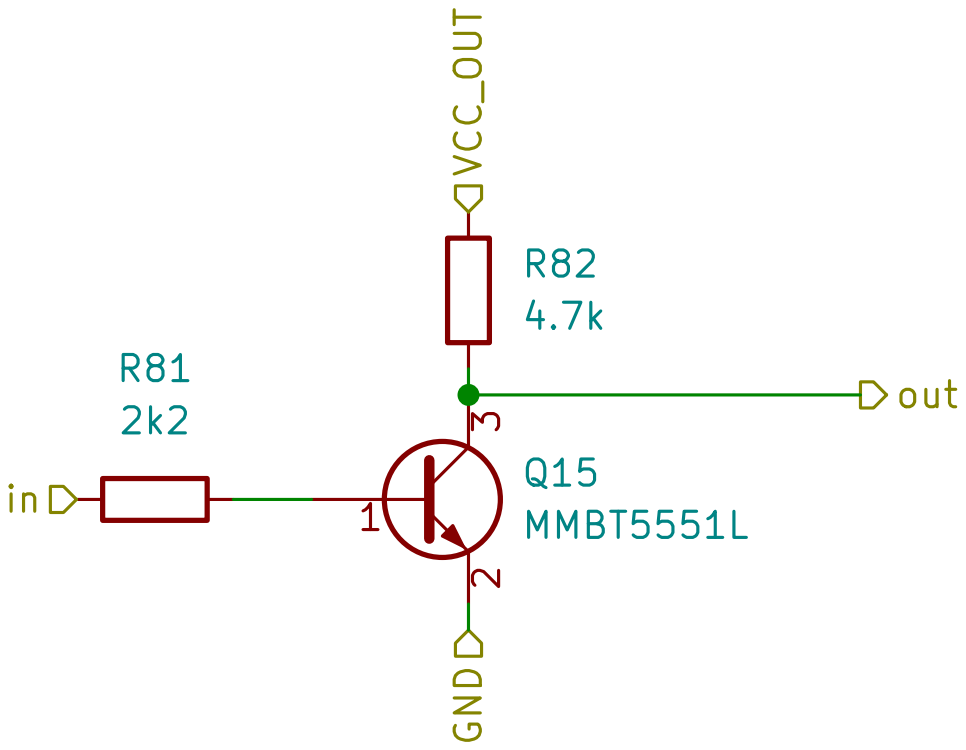
[picture p43: page 42]

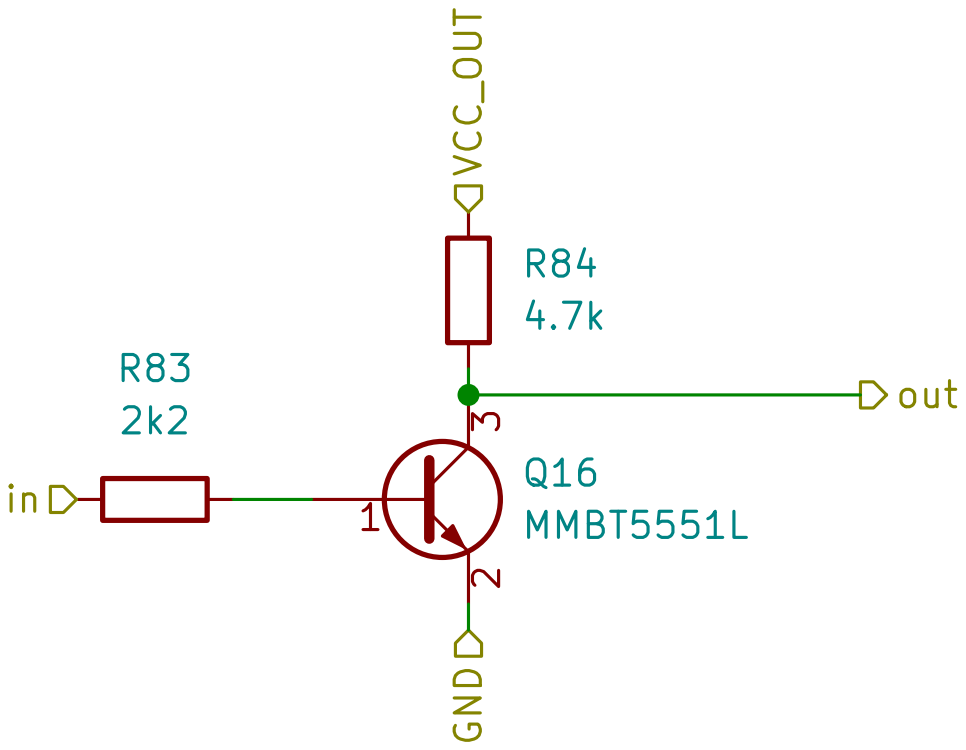
[picture p44: page 43]

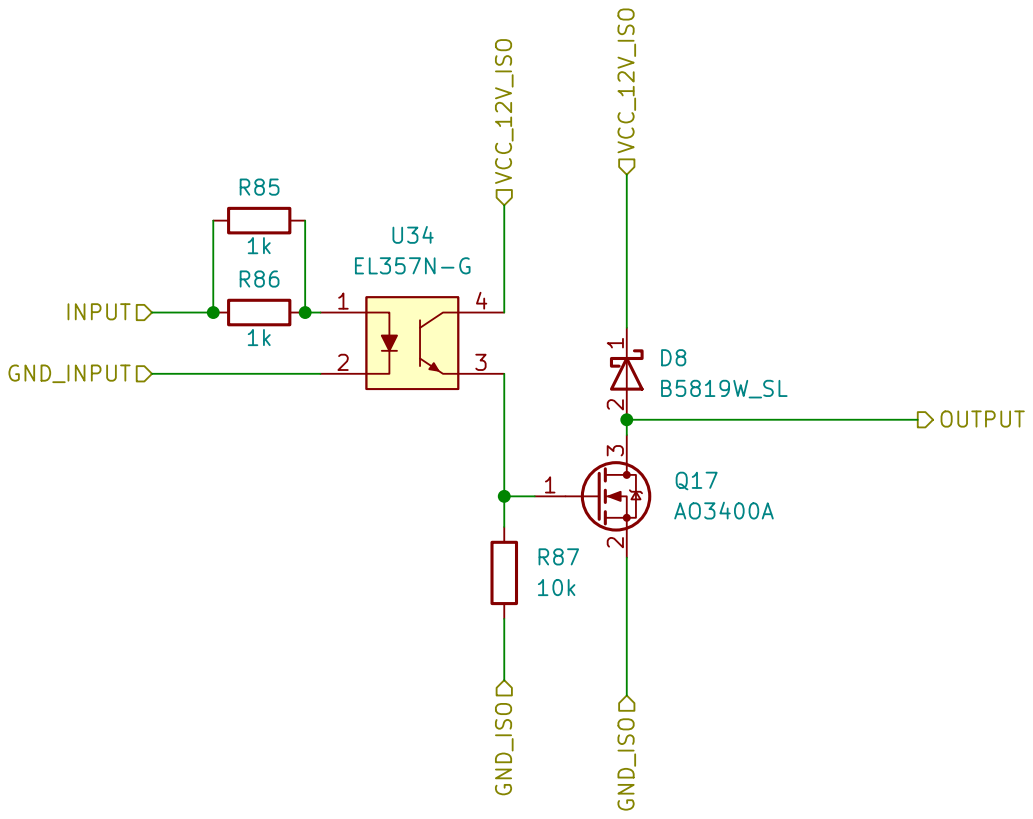
[picture p45: page 44]

Sheet: /Spindle isolated analog/digital_out/
File: digital_out.kicad_sch
Id: #/45 Title:

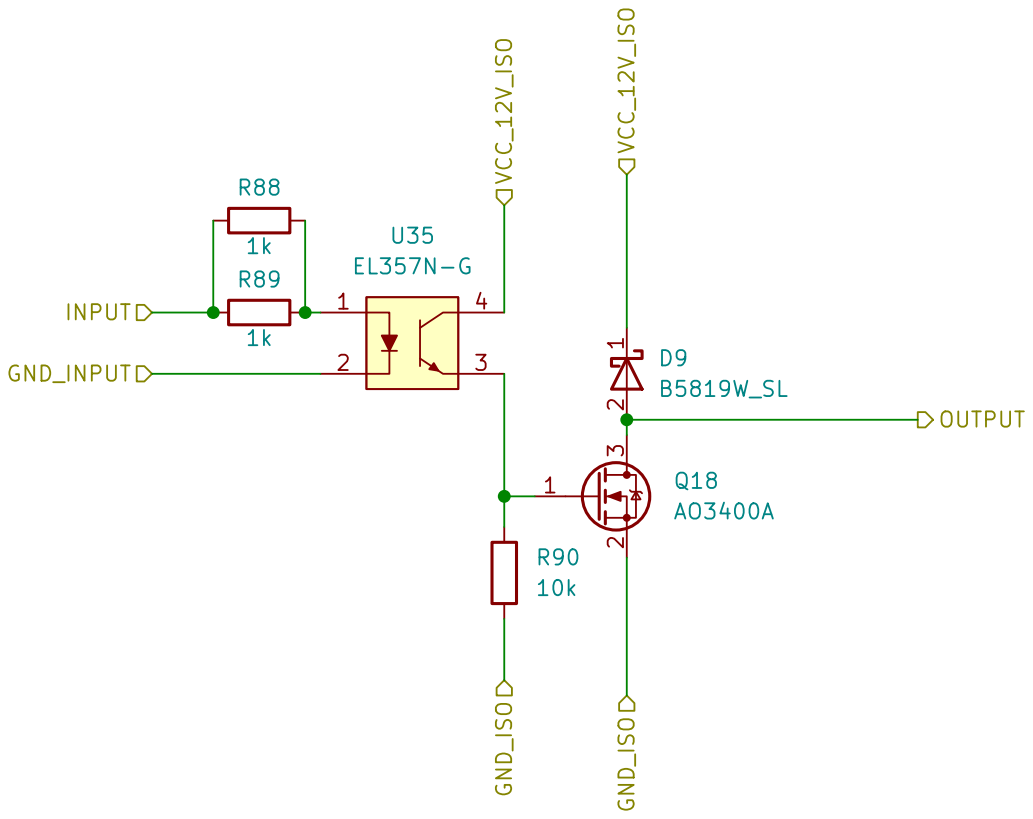
[picture p46: page 45]

Sheet: /Spindle isolated analog/digital_out1/
File: digital_out.kicad_sch
Id: #/45 Title:
