lemwill/QuarkCnc/Input_Protection.kicad_sch

## KiCad design Input_Protection.kicad_sch (2022-05-05)

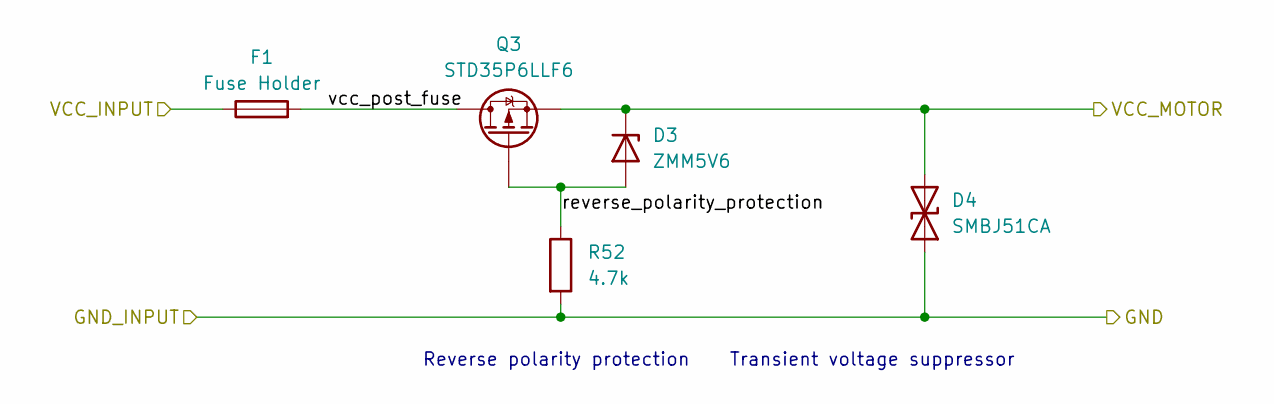
[picture p47: schematic Input_Protection.kicad_sch]

Parts:
D3: ZMM5V6; D_MiniMELF; LCSC C8062
D4: SMBJ51CA; D_SMB; LCSC C151265
F1: Fuse Holder; Fuse_Littelfuse_178.6764.0001; LCSC C142933
Q3: STD35P6LLF6; TO-252-2; LCSC C165929
R52: 4.7k; R_0805_2012Metric; LCSC C17673

Connections:
GND: D4.1 (A1), R52.2
VCC_INPUT: F1.1
VCC_MOTOR: D3.1 (K), D4.2 (A2), Q3.3 (D)
reverse_polarity_protection: D3.2 (A), Q3.1 (G), R52.1
vcc_post_fuse: F1.2, Q3.2 (D)

Notes on the sheet:
Reverse polarity protection
Transient voltage suppressor
