lemwill/QuarkCnc/Isolated supply 12V.kicad_sch

## KiCad design Isolated supply 12V.kicad_sch (2022-05-05)

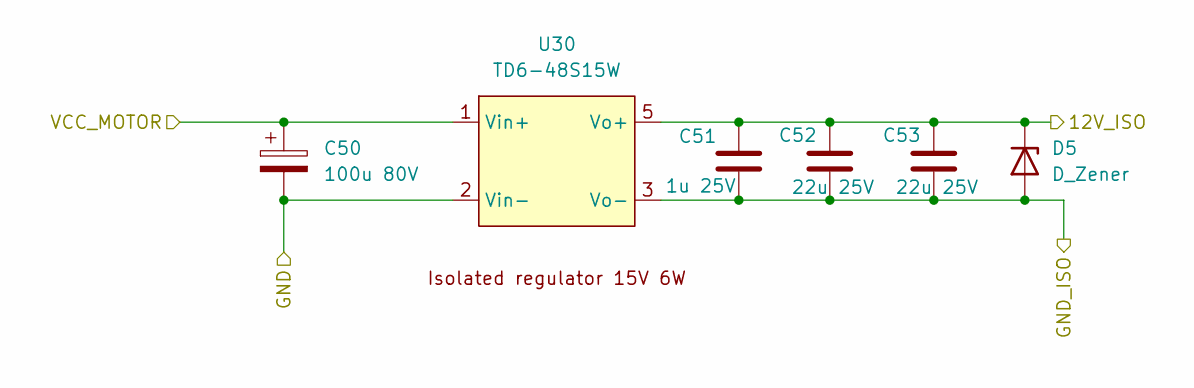
[picture p48: schematic Isolated supply 12V.kicad_sch]

Parts:
C50: 100u 80V; CP_Elec_10x10; LCSC C487410
C51: 1u 25V; C_0402_1005Metric; LCSC C52923
C52, C53: 22u 25V; C_1206_3216Metric; LCSC C12891
D5: D_Zener; D_SMB; LCSC C435935
U30: TD6-48S15W; LCSC C570771

Connections:
12V_ISO: C51.1, C52.1, C53.1, D5.1 (K), U30.5 (Vo+)
GND: C50.2, U30.2 (Vin-)
GND_ISO: C51.2, C52.2, C53.2, D5.2 (A), U30.3 (Vo-)
VCC_MOTOR: C50.1, U30.1 (Vin+)
