lemwill/QuarkCnc/Isolated_supply_5V_15W.kicad_sch

## KiCad design Isolated_supply_5V_15W.kicad_sch (2022-05-05)

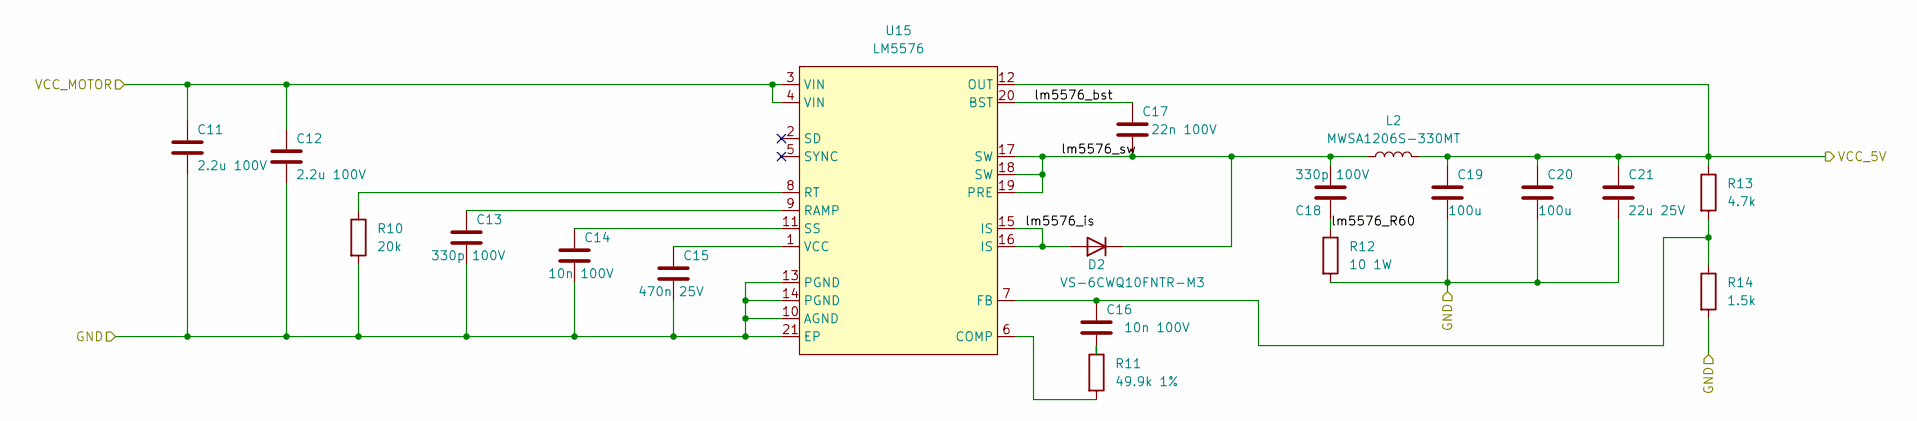
[picture p49: schematic Isolated_supply_5V_15W.kicad_sch]

Parts:
C11, C12: 2.2u 100V; C_1812_4532Metric; LCSC C106162
C13, C18: 330p 100V; C_0805_2012Metric; LCSC C113820
C14, C16: 10n 100V; C_0805_2012Metric; LCSC C107135
C15: 470n 25V; C_0603_1608Metric; LCSC C1623
C17: 22n 100V; C_0805_2012Metric; LCSC C107137
C19, C20: 100u; C_1206_3216Metric; LCSC C15008
C21: 22u 25V; C_1206_3216Metric; LCSC C12891
D2: VS-6CWQ10FNTR-M3; LCSC C468124
L2: MWSA1206S-330MT; MWSA1004S-330MT; LCSC C408490
R10: 20k; R_0805_2012Metric; LCSC C4328
R11: 49.9k 1%; R_0805_2012Metric; LCSC C17719
R12: 10 1W; R_2512_6332Metric; LCSC C47019
R13: 4.7k; R_0805_2012Metric; LCSC C17673
R14: 1.5k; R_0805_2012Metric; LCSC C104027
U15: LM5576; HTSSOP-20-1EP_4.4x6.5mm_P0.65mm_EP2.85x4mm; LCSC C62562

Connections:
GND: C11.2, C12.2, C13.2, C14.2, C15.2, C19.2, C20.2, C21.2, R10.2, R12.2, R14.2, U15.10 (AGND), U15.13 (PGND), U15.14 (PGND), U15.21 (EP)
unnamed: C13.1, U15.9 (RAMP)
unnamed: C14.1, U15.11 (SS)
unnamed: C15.1, U15.1 (VCC)
unnamed: C16.1, R13.2, R14.1, U15.7 (FB)
unnamed: C16.2, R11.1
unnamed: R10.1, U15.8 (RT)
unnamed: R11.2, U15.6 (COMP)
VCC_5V: C19.1, C20.1, C21.1, L2.2, R13.1, U15.12 (OUT)
VCC_MOTOR: C11.1, C12.1, U15.3 (VIN), U15.4 (VIN)
lm5576_R60: C18.2, R12.1
lm5576_bst: C17.1, U15.20 (BST)
lm5576_is: D2.2 (A), U15.15 (IS), U15.16 (IS)
lm5576_sw: C17.2, C18.1, D2.1 (K), L2.1, U15.17 (SW), U15.18 (SW), U15.19 (PRE)
