lemwill/QuarkCnc/QuarkCnc.kicad_sch

## KiCad design QuarkCnc.kicad_sch (2022-05-05)

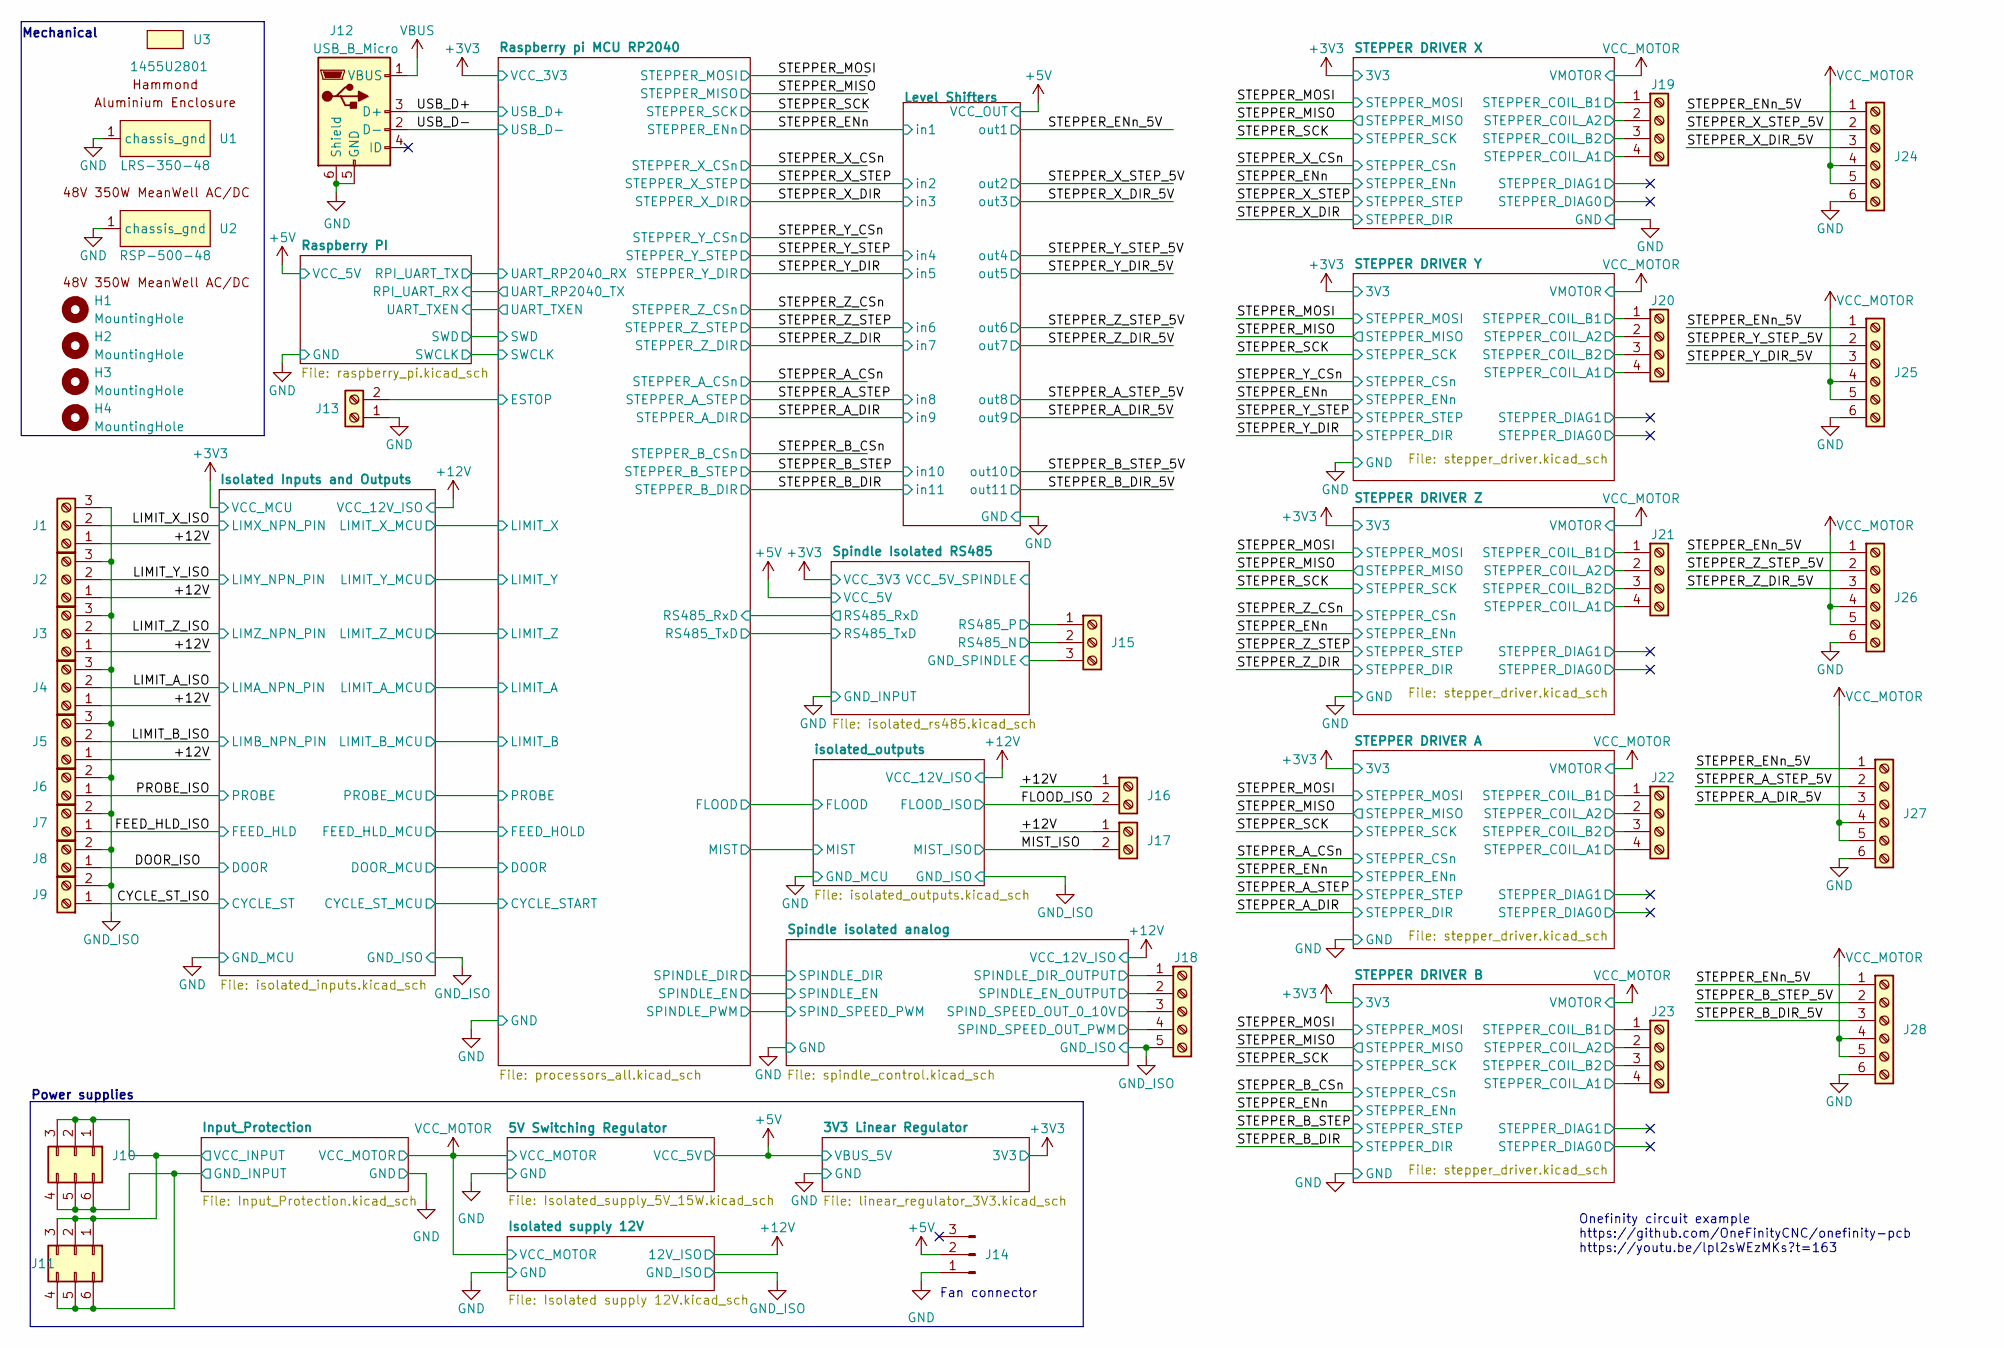
[picture p50: schematic QuarkCnc.kicad_sch]

Parts:
H1, H2, H3, H4: MountingHole; MountingHole_4.3mm_M4_ISO7380
J1, J2, J3, J4, J5: Screw_Terminal_01x03; TerminalBlock_Phoenix_PTSM-0,5-3-2.5-H-THR_1x03_P2.50mm_Hor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
J6, J7, J8, J9, J16, J17: Screw_Terminal_01x02; TerminalBlock_Phoenix_PTSM-0,5-2-2.5-H-THR_1x02_P2.50mm_Hor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
J10: Conn_02x03_Counter_Clockwise; Molex_Mini-Fit_Jr_5569-06A2_2x03_P4.20mm_Horizontal; LCSC C293509
J11: Conn_02x03_Counter_Clockwise; Molex_Mini-Fit_Jr_5566-06A_2x03_P4.20mm_Vertical; LCSC C293509
J12: USB_B_Micro; USB_Micro-B_Amphenol_10118194_Horizontal; LCSC C132563
J13: Screw_Terminal_01x02; TerminalBlock_Phoenix_PTSM-0,5-2-2.5-H-THR_1x02_P2.50mm_Hor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; LCSC C122431
J14: Conn_01x03_Male; Molex_KK-254_AE-6410-03A_1x03_P2.54mm_Vertical
J15: Screw_Terminal_01x03; TerminalBlock_Phoenix_PTSM-0,5-3-2.5-H-THR_1x03_P2.50mm_Hor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; LCSC C503478
J18: Screw_Terminal_01x05; TerminalBlock_Phoenix_PTSM-0,5-5-2.5-H-THR_1x05_P2.50mm_Hor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
J19, J20, J21, J22, J23: Screw_Terminal_01x04; Molex_Micro-Fit_3.0_43045-0400_2x02_P3.00mm_Horizontal; LCSC C122413
J24, J25, J26, J27, J28: Screw_Terminal_01x06; Molex_Micro-Fit_3.0_43045-0600_2x03_P3.00mm_Horizontal
U1: LRS-350-48
U2: RSP-500-48
U3: 1455U2801

Connections:
+5V: J14.2
+12V: J1.1, J2.1, J3.1, J4.1, J5.1, J16.1, J17.1
CYCLE_ST_ISO: J9.1
DOOR_ISO: J8.1
ESTOP: J13.2
FEED_HLD_ISO: J7.1
FLOOD_ISO: J16.2
GND: J12.5 (GND), J12.6 (Shield), J13.1, J14.1, J24.6, J25.6, J26.6, J27.6, J28.6, U1.1, U2.1
GND_INPUT: J10.4, J10.5, J10.6, J11.4, J11.5, J11.6
GND_ISO: J1.3, J2.3, J3.3, J4.3, J5.3, J6.2, J7.2, J8.2, J9.2, J18.5
GND_SPINDLE: J15.3
LIMIT_A_ISO: J4.2
LIMIT_B_ISO: J5.2
LIMIT_X_ISO: J1.2
LIMIT_Y_ISO: J2.2
LIMIT_Z_ISO: J3.2
MIST_ISO: J17.2
PROBE_ISO: J6.1
RS485_N: J15.2
RS485_P: J15.1
SPINDLE_DIR_OUTPUT: J18.1
SPINDLE_EN_OUTPUT: J18.2
SPIND_SPEED_OUT_0_10V: J18.3
SPIND_SPEED_OUT_PWM: J18.4
STEPPER_A_DIR_5V: J27.3
STEPPER_A_STEP_5V: J27.2
STEPPER_B_DIR_5V: J28.3
STEPPER_B_STEP_5V: J28.2
STEPPER_COIL_A1: J19.4, J20.4, J21.4, J22.4, J23.4
STEPPER_COIL_A2: J19.2, J20.2, J21.2, J22.2, J23.2
STEPPER_COIL_B1: J19.1, J20.1, J21.1, J22.1, J23.1
STEPPER_COIL_B2: J19.3, J20.3, J21.3, J22.3, J23.3
STEPPER_ENn_5V: J24.1, J25.1, J26.1, J27.1, J28.1
STEPPER_X_DIR_5V: J24.3
STEPPER_X_STEP_5V: J24.2
STEPPER_Y_DIR_5V: J25.3
STEPPER_Y_STEP_5V: J25.2
STEPPER_Z_DIR_5V: J26.3
STEPPER_Z_STEP_5V: J26.2
USB_D+: J12.3 (D+)
USB_D-: J12.2 (D-)
VBUS: J12.1 (VBUS)
VCC_INPUT: J10.1, J10.2, J10.3, J11.1, J11.2, J11.3
VCC_MOTOR: J24.4, J24.5, J25.4, J25.5, J26.4, J26.5, J27.4, J27.5, J28.4, J28.5

Notes on the sheet:
Mechanical
Fan connector
Onefinity circuit example https://github.com/OneFinityCNC/onefinity-pcb https://youtu.be/lpl2sWEzMKs?t=163
Power supplies
