lemwill/QuarkCnc/debounce.kicad_sch

## KiCad design debounce.kicad_sch (2022-05-05)

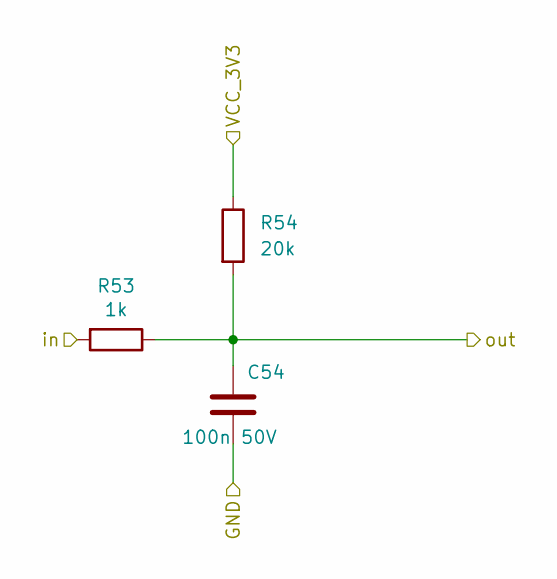
[picture p51: schematic debounce.kicad_sch]

Parts:
C54: 100n 50V; C_0402_1005Metric; LCSC C307331
R53: 1k; R_1206_3216Metric; LCSC C4410
R54: 20k; R_0805_2012Metric; LCSC C4328

Connections:
GND: C54.2
VCC_3V3: R54.1
in: R53.2
out: C54.1, R53.1, R54.2
