lemwill/QuarkCnc/digital_out.kicad_sch

## KiCad design digital_out.kicad_sch (2022-05-05)

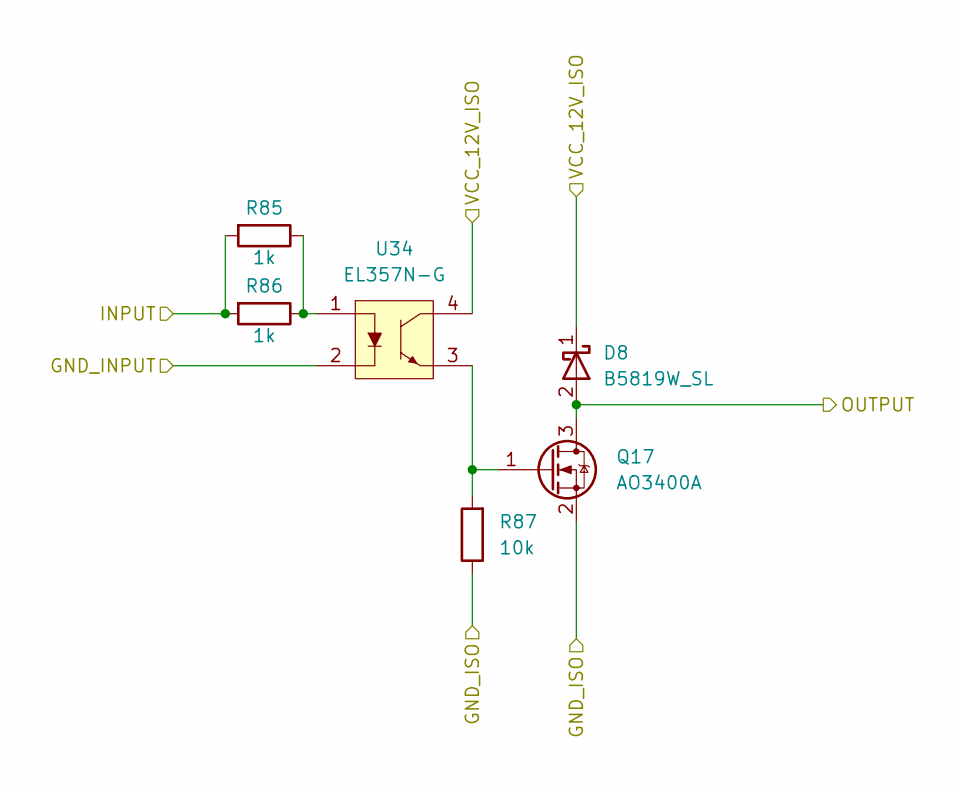
[picture p52: schematic digital_out.kicad_sch]

Parts:
D8: B5819W_SL; D_SOD-123; LCSC C8598
Q17: AO3400A; SOT-23; LCSC C20917
R85, R86: 1k; R_1206_3216Metric; LCSC C4410
R87: 10k; R_0402_1005Metric_Pad0.72x0.64mm_HandSolder; LCSC C25744
U34: EL357N-G; SOP254P700X200-4N; LCSC C29981

Connections:
GND_INPUT: U34.2
GND_ISO: Q17.2 (S), R87.1
INPUT: R85.2, R86.2
unnamed: Q17.1 (G), R87.2, U34.3
unnamed: R85.1, R86.1, U34.1
OUTPUT: D8.2 (A), Q17.3 (D)
VCC_12V_ISO: D8.1 (K), U34.4
