lemwill/QuarkCnc/emergency_stop.kicad_sch

## KiCad design emergency_stop.kicad_sch (2022-05-05)

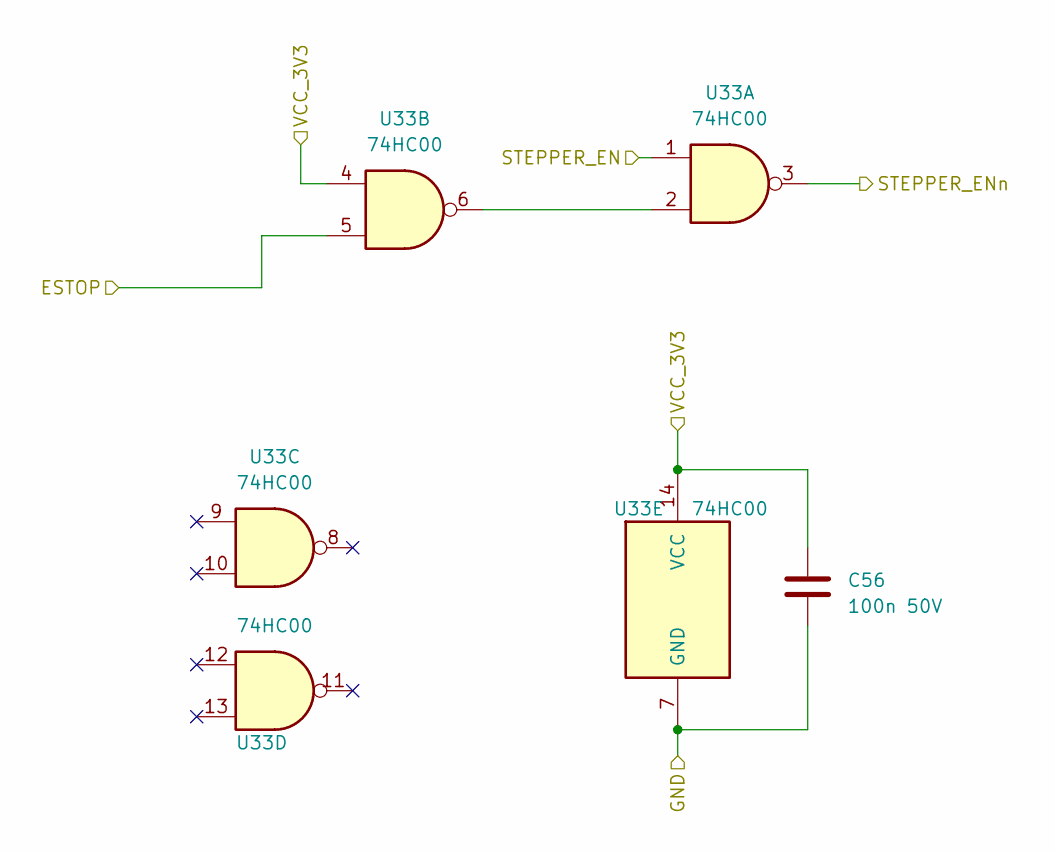
[picture p53: schematic emergency_stop.kicad_sch]

Parts:
C56: 100n 50V; C_0402_1005Metric; LCSC C307331
U33: 74HC00

Connections:
ESTOP: U33.5
GND: C56.2, U33.7 (GND)
unnamed: U33.2, U33.6
STEPPER_EN: U33.1
STEPPER_ENn: U33.3
VCC_3V3: C56.1, U33.4, U33.14 (VCC)
