lemwill/QuarkCnc/isolated_input.kicad_sch

## KiCad design isolated_input.kicad_sch (2022-05-05)

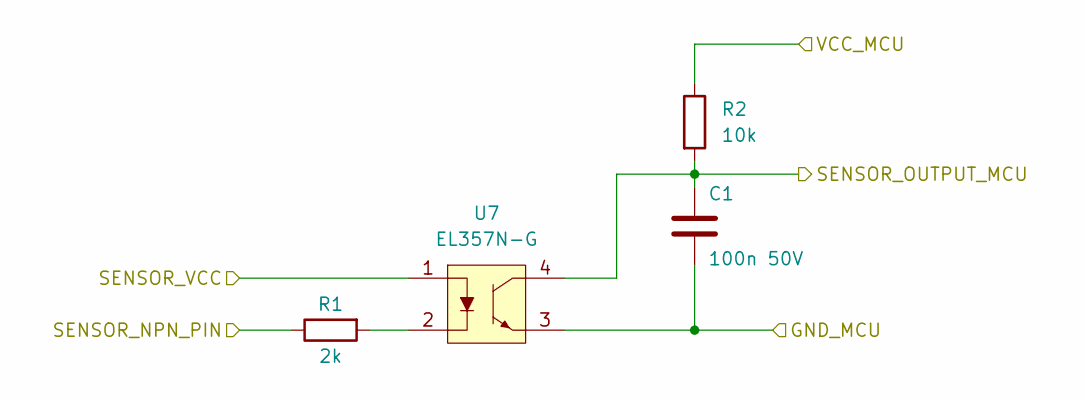
[picture p54: schematic isolated_input.kicad_sch]

Parts:
C1: 100n 50V; C_0402_1005Metric; LCSC C307331
R1: 2k; R_1206_3216Metric; LCSC C17944
R2: 10k; R_0402_1005Metric_Pad0.72x0.64mm_HandSolder; LCSC C25744
U7: EL357N-G; SOP254P700X200-4N; LCSC C29981

Connections:
GND_MCU: C1.2, U7.3
unnamed: R1.2, U7.2
SENSOR_NPN_PIN: R1.1
SENSOR_OUTPUT_MCU: C1.1, R2.2, U7.4
SENSOR_VCC: U7.1
VCC_MCU: R2.1
