lemwill/QuarkCnc/isolated_rs485.kicad_sch

## KiCad design isolated_rs485.kicad_sch (2022-05-05)

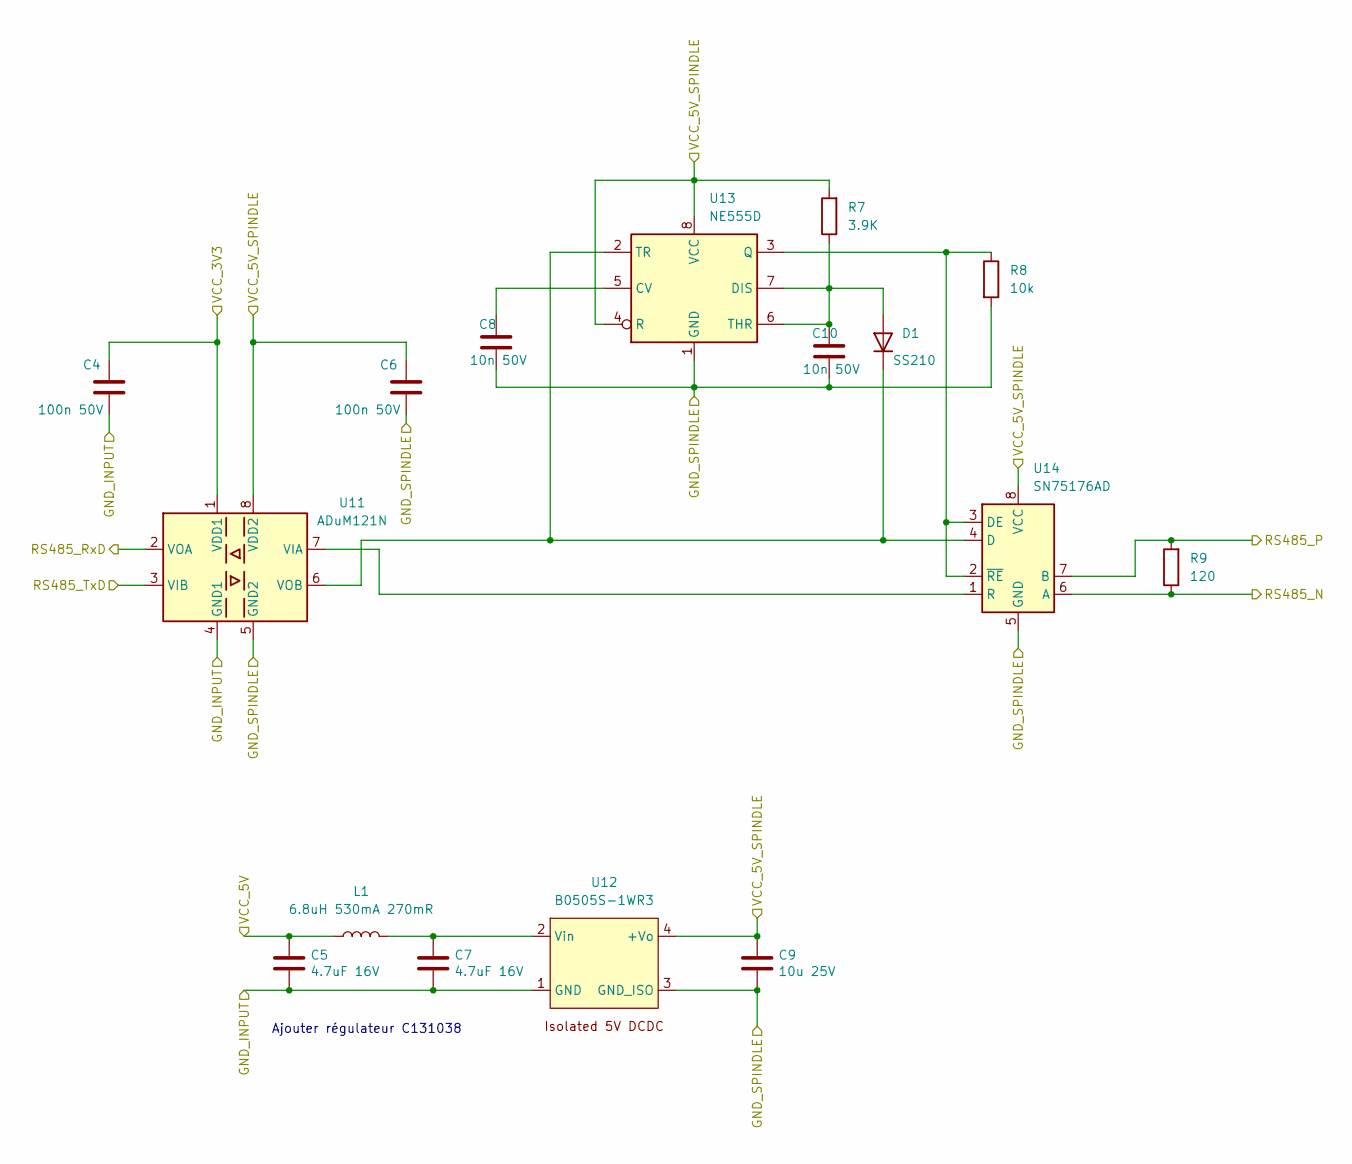
[picture p55: schematic isolated_rs485.kicad_sch]

Parts:
C4, C6: 100n 50V; C_0402_1005Metric; LCSC C307331
C5, C7: 4.7uF 16V; C_0603_1608Metric; LCSC C19666
C8, C10: 10n 50V; C_0402_1005Metric; LCSC C15195
C9: 10u 25V; C_0805_2012Metric; LCSC C15850
D1: SS210; D_SMA; LCSC C14996
L1: 6.8uH 530mA 270mR; L_TDK_NLV32_3.2x2.5mm; LCSC C295387
R7: 3.9K; R_0402_1005Metric; LCSC C51721
R8: 10k; R_0402_1005Metric_Pad0.72x0.64mm_HandSolder; LCSC C25744
R9: 120; R_1206_3216Metric; LCSC C17909
U11: ADuM121N; SOIC-8_3.9x4.9mm_P1.27mm; LCSC C190783
U12: B0505S-1WR3
U13: NE555D; SOIC-8_3.9x4.9mm_P1.27mm; LCSC C7593
U14: SN75176AD; SOIC-8_3.9x4.9mm_P1.27mm; LCSC C7063

Connections:
GND_INPUT: C4.2, C5.2, C7.2, U11.4 (GND1), U12.1 (GND)
GND_SPINDLE: C6.2, C8.2, C9.2, C10.2, R8.2, U11.5 (GND2), U12.3 (GND_ISO), U13.1 (GND), U14.5 (GND)
unnamed: C7.1, L1.2, U12.2 (Vin)
unnamed: C8.1, U13.5 (CV)
unnamed: C10.1, D1.2 (A), R7.1, U13.6 (THR), U13.7 (DIS)
unnamed: D1.1 (K), U11.6 (VOB), U13.2 (TR), U14.4 (D)
unnamed: R8.1, U13.3 (Q), U14.2 (~RE), U14.3 (DE)
unnamed: U11.7 (VIA), U14.1 (R)
RS485_N: R9.1, U14.6 (A)
RS485_P: R9.2, U14.7 (B)
RS485_RxD: U11.2 (VOA)
RS485_TxD: U11.3 (VIB)
VCC_3V3: C4.1, U11.1 (VDD1)
VCC_5V: C5.1, L1.1
VCC_5V_SPINDLE: C6.1, C9.1, R7.2, U11.8 (VDD2), U12.4 (+Vo), U13.4 (R), U13.8 (VCC), U14.8 (VCC)

Notes on the sheet:
Ajouter régulateur C131038
