lemwill/QuarkCnc/linear_regulator_3V3.kicad_sch

## KiCad design linear_regulator_3V3.kicad_sch (2022-05-05)

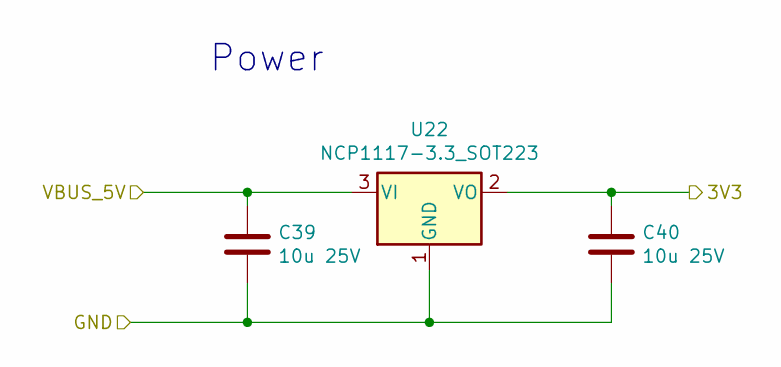
[picture p56: schematic linear_regulator_3V3.kicad_sch]

Parts:
C39, C40: 10u 25V; C_0805_2012Metric; LCSC C15850
U22: NCP1117-3.3_SOT223; SOT-223-3_TabPin2; LCSC C26537

Connections:
3V3: C40.1, U22.2 (VO)
GND: C39.2, C40.2, U22.1 (GND)
VBUS_5V: C39.1, U22.3 (VI)

Notes on the sheet:
Power
