lemwill/QuarkCnc/microcontroller.kicad_sch

## KiCad design microcontroller.kicad_sch (2022-05-05)

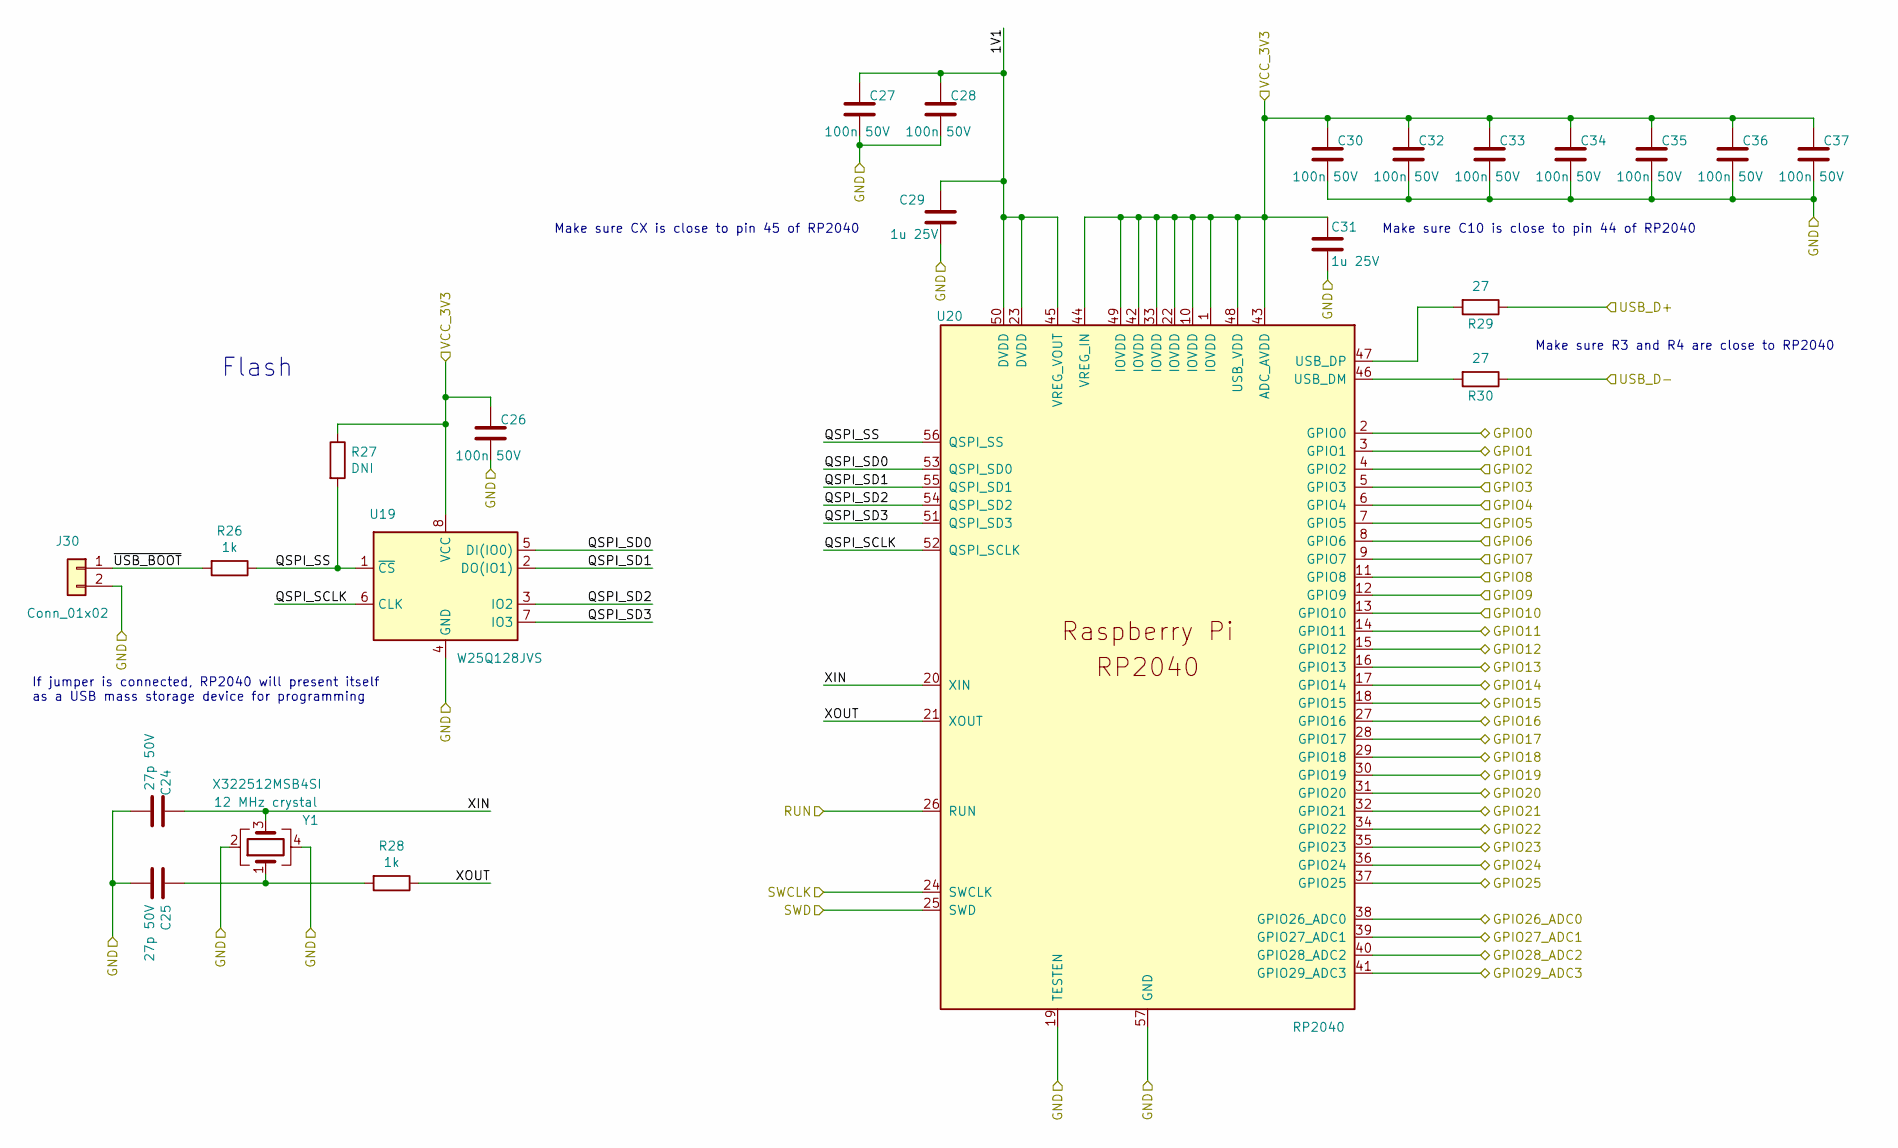
[picture p57: schematic microcontroller.kicad_sch]

Parts:
C24, C25: 27p 50V; C_0402_1005Metric; LCSC C1557
C26, C27, C28, C30, C32, C33, C34, C35, C36, C37: 100n 50V; C_0402_1005Metric; LCSC C307331
C29, C31: 1u 25V; C_0402_1005Metric; LCSC C52923
J30: Conn_01x02; PinHeader_1x02_P2.54mm_Vertical; LCSC C492401
R26, R28: 1k; R_1206_3216Metric; LCSC C4410
R27: DNI; C_0402_1005Metric
R29, R30: 27; R_0603_1608Metric; LCSC C25190
U19: W25Q128JVS; SOIC-8_5.23x5.23mm_P1.27mm; LCSC C97521
U20: RP2040; RP2040-QFN-56; LCSC C2040
Y1: X322512MSB4SI; Crystal_SMD_3225-4Pin_3.2x2.5mm_HandSoldering; LCSC C9002

Connections:
1V1: C27.1, C28.1, C29.1, U20.23 (DVDD), U20.45 (VREG_VOUT), U20.50 (DVDD)
GND: C24.2, C25.2, C26.2, C27.2, C28.2, C29.2, C30.2, C31.2, C32.2, C33.2, C34.2, C35.2, C36.2, C37.2, J30.2, U19.4 (GND), U20.19 (TESTEN), U20.57 (GND), Y1.2, Y1.4
GPIO0: U20.2 (GPIO0)
GPIO1: U20.3 (GPIO1)
GPIO2: U20.4 (GPIO2)
GPIO3: U20.5 (GPIO3)
GPIO4: U20.6 (GPIO4)
GPIO5: U20.7 (GPIO5)
GPIO6: U20.8 (GPIO6)
GPIO7: U20.9 (GPIO7)
GPIO8: U20.11 (GPIO8)
GPIO9: U20.12 (GPIO9)
GPIO10: U20.13 (GPIO10)
GPIO11: U20.14 (GPIO11)
GPIO12: U20.15 (GPIO12)
GPIO13: U20.16 (GPIO13)
GPIO14: U20.17 (GPIO14)
GPIO15: U20.18 (GPIO15)
GPIO16: U20.27 (GPIO16)
GPIO17: U20.28 (GPIO17)
GPIO18: U20.29 (GPIO18)
GPIO19: U20.30 (GPIO19)
GPIO20: U20.31 (GPIO20)
GPIO21: U20.32 (GPIO21)
GPIO22: U20.34 (GPIO22)
GPIO23: U20.35 (GPIO23)
GPIO24: U20.36 (GPIO24)
GPIO25: U20.37 (GPIO25)
GPIO26_ADC0: U20.38 (GPIO26_ADC0)
GPIO27_ADC1: U20.39 (GPIO27_ADC1)
GPIO28_ADC2: U20.40 (GPIO28_ADC2)
GPIO29_ADC3: U20.41 (GPIO29_ADC3)
unnamed: C25.1, R28.2, Y1.1
unnamed: R29.2, U20.47 (USB_DP)
unnamed: R30.2, U20.46 (USB_DM)
QSPI_SCLK: U19.6 (CLK), U20.52 (QSPI_SCLK)
QSPI_SD0: U19.5 (DI(IO0)), U20.53 (QSPI_SD0)
QSPI_SD1: U19.2 (DO(IO1)), U20.55 (QSPI_SD1)
QSPI_SD2: U19.3 (IO2), U20.54 (QSPI_SD2)
QSPI_SD3: U19.7 (IO3), U20.51 (QSPI_SD3)
QSPI_SS: R26.1, R27.2, U19.1 (~CS), U20.56 (QSPI_SS)
RUN: U20.26 (RUN)
SWCLK: U20.24 (SWCLK)
SWD: U20.25 (SWD)
USB_D+: R29.1
USB_D-: R30.1
VCC_3V3: C26.1, C30.1, C31.1, C32.1, C33.1, C34.1, C35.1, C36.1, C37.1, R27.1, U19.8 (VCC), U20.1 (IOVDD), U20.10 (IOVDD), U20.22 (IOVDD), U20.33 (IOVDD), U20.42 (IOVDD), U20.43 (ADC_AVDD), U20.44 (VREG_IN), U20.48 (USB_VDD), U20.49 (IOVDD)
XIN: C24.1, U20.20 (XIN), Y1.3
XOUT: R28.1, U20.21 (XOUT)
~USB_BOOT: J30.1, R26.2

Notes on the sheet:
Make sure CX is close to pin 45 of RP2040
Make sure C10 is close to pin 44 of RP2040
Make sure R3 and R4 are close to RP2040
If jumper is connected, RP2040 will present itself as a USB mass storage device for programming
Flash
