lemwill/QuarkCnc/processors_all.kicad_sch

## KiCad design processors_all.kicad_sch (2022-05-05)

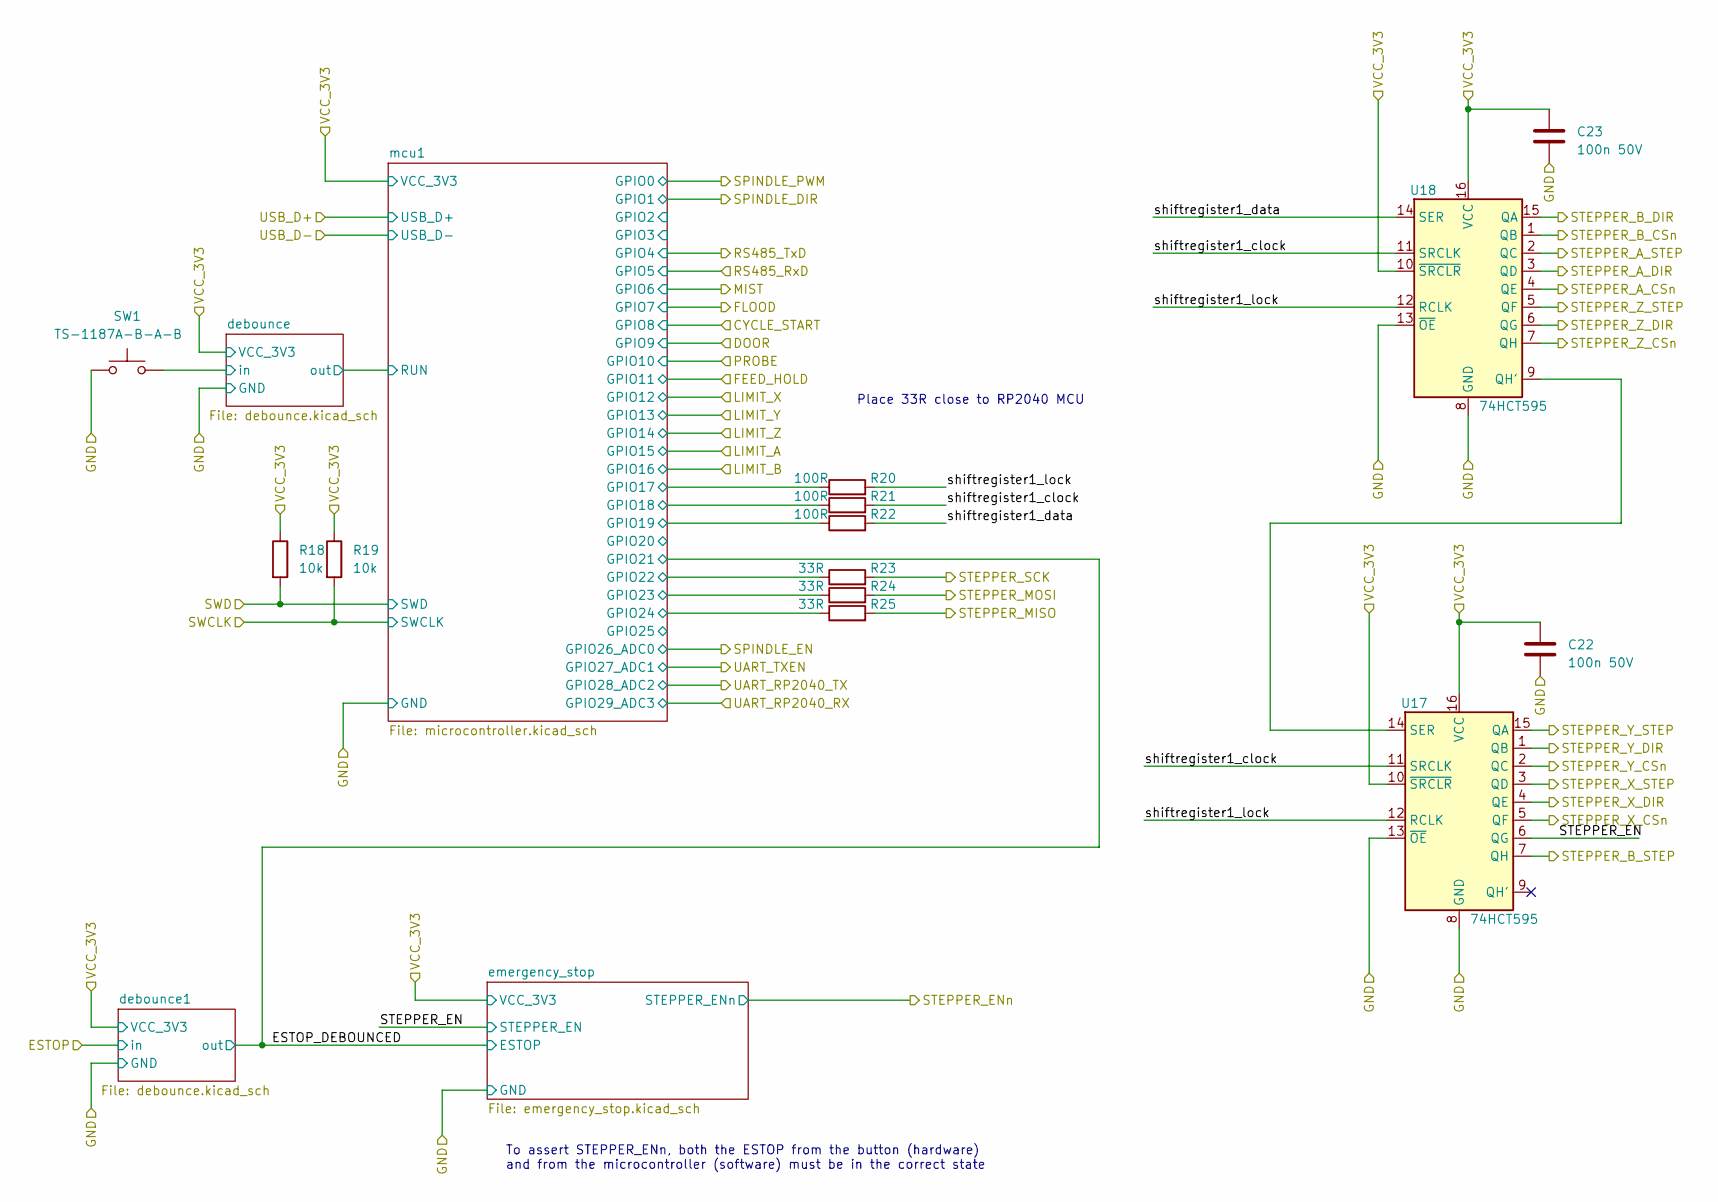
[picture p58: schematic processors_all.kicad_sch]

Parts:
C22, C23: 100n 50V; C_0402_1005Metric; LCSC C307331
R18, R19: 10k; R_0402_1005Metric_Pad0.72x0.64mm_HandSolder; LCSC C25744
R20, R21, R22: 100R; R_0603_1608Metric; LCSC C22775
R23, R24, R25: 33R; R_0402_1005Metric; LCSC C25105
SW1: TS-1187A-B-A-B; SW_SPST_TL3342; LCSC C318884
U17, U18: 74HCT595; SOIC-16_3.9x9.9mm_P1.27mm; LCSC C5947

Connections:
GND: C22.2, C23.2, SW1.1, U17.8 (GND), U17.13 (~OE), U18.8 (GND), U18.13 (~OE)
GPIO17: R20.1
GPIO18: R21.1
GPIO19: R22.1
GPIO22: R23.1
GPIO23: R24.1
GPIO24: R25.1
unnamed: U17.14 (SER), U18.9 (QH')
STEPPER_A_CSn: U18.4 (QE)
STEPPER_A_DIR: U18.3 (QD)
STEPPER_A_STEP: U18.2 (QC)
STEPPER_B_CSn: U18.1 (QB)
STEPPER_B_DIR: U18.15 (QA)
STEPPER_B_STEP: U17.7 (QH)
STEPPER_EN: U17.6 (QG)
STEPPER_MISO: R25.2
STEPPER_MOSI: R24.2
STEPPER_SCK: R23.2
STEPPER_X_CSn: U17.5 (QF)
STEPPER_X_DIR: U17.4 (QE)
STEPPER_X_STEP: U17.3 (QD)
STEPPER_Y_CSn: U17.2 (QC)
STEPPER_Y_DIR: U17.1 (QB)
STEPPER_Y_STEP: U17.15 (QA)
STEPPER_Z_CSn: U18.7 (QH)
STEPPER_Z_DIR: U18.6 (QG)
STEPPER_Z_STEP: U18.5 (QF)
SWCLK: R19.2
SWD: R18.2
VCC_3V3: C22.1, C23.1, R18.1, R19.1, U17.10 (~SRCLR), U17.16 (VCC), U18.10 (~SRCLR), U18.16 (VCC)
in: SW1.2
shiftregister1_clock: R21.2, U17.11 (SRCLK), U18.11 (SRCLK)
shiftregister1_data: R22.2, U18.14 (SER)
shiftregister1_lock: R20.2, U17.12 (RCLK), U18.12 (RCLK)

Notes on the sheet:
Place 33R close to RP2040 MCU
To assert STEPPER_ENn, both the ESTOP from the button (hardware) and from the microcontroller (software) must be in the correct state
