lemwill/QuarkCnc/raspberry_pi.kicad_sch

## KiCad design raspberry_pi.kicad_sch (2022-05-05)

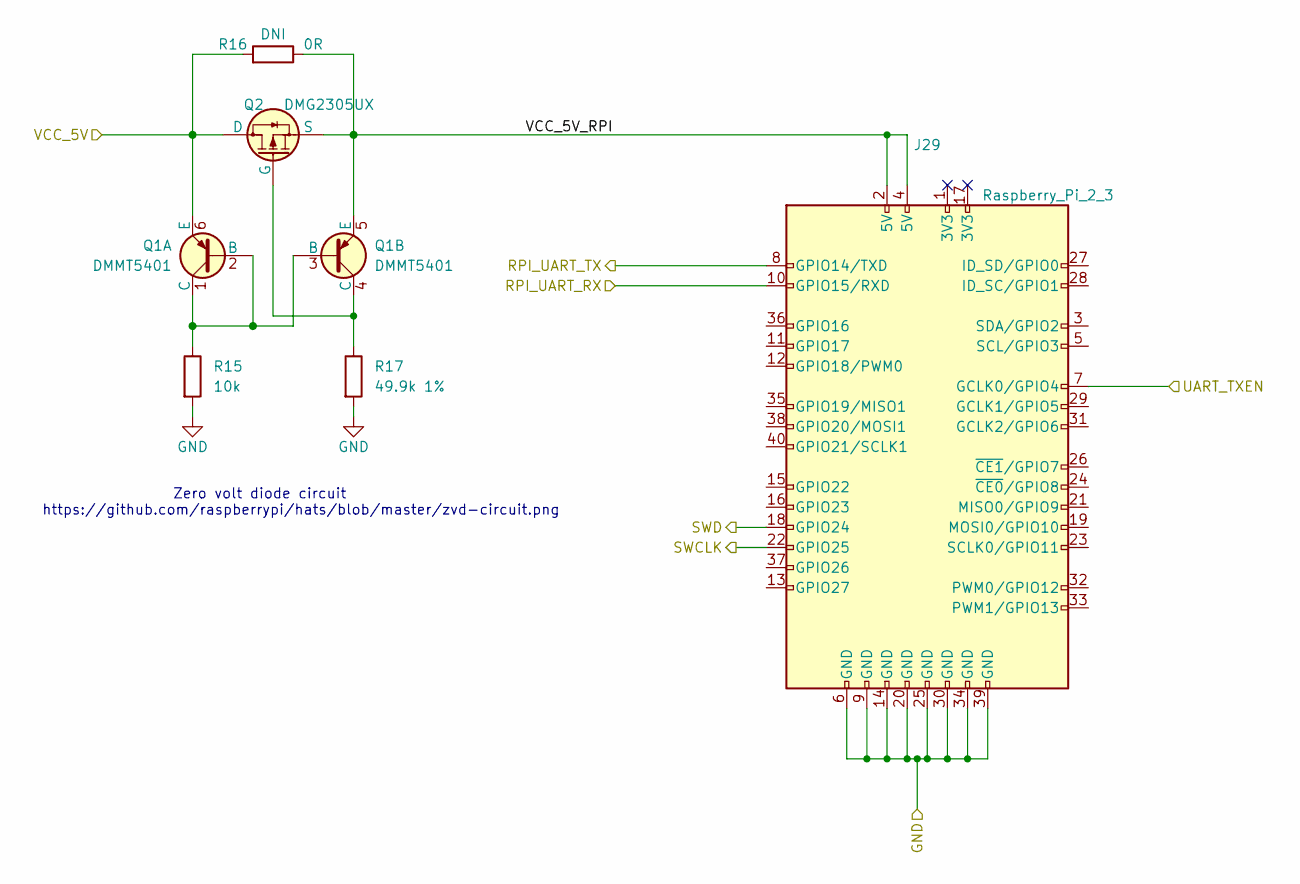
[picture p59: schematic raspberry_pi.kicad_sch]

Parts:
J29: Raspberry_Pi_2_3; Raspberry PI 4
Q1: DMMT5401; SOT-23-6; LCSC C154733
Q2: DMG2305UX; SOT-23; LCSC C150470
R15: 10k; R_0402_1005Metric_Pad0.72x0.64mm_HandSolder; LCSC C25744
R16: 0R; R_0805_2012Metric
R17: 49.9k 1%; R_0805_2012Metric; LCSC C17719

Connections:
GND: J29.6 (GND), J29.9 (GND), J29.14 (GND), J29.20 (GND), J29.25 (GND), J29.30 (GND), J29.34 (GND), J29.39 (GND), R15.2, R17.2
unnamed: Q1.1 (C), Q1.2 (B), Q1.3 (B), R15.1
unnamed: Q1.4 (C), Q2.1 (G), R17.1
RPI_UART_RX: J29.10 (GPIO15/RXD)
RPI_UART_TX: J29.8 (GPIO14/TXD)
SWCLK: J29.22 (GPIO25)
SWD: J29.18 (GPIO24)
UART_TXEN: J29.7 (GCLK0/GPIO4)
VCC_5V: Q1.6 (E), Q2.3 (D), R16.2
VCC_5V_RPI: J29.2 (5V), J29.4 (5V), Q1.5 (E), Q2.2 (S), R16.1

Notes on the sheet:
https://github.com/raspberrypi/hats/blob/master/zvd-circuit.png
Zero volt diode circuit
