lemwill/QuarkCnc/spindle_control.kicad_sch

## KiCad design spindle_control.kicad_sch (2022-05-05)

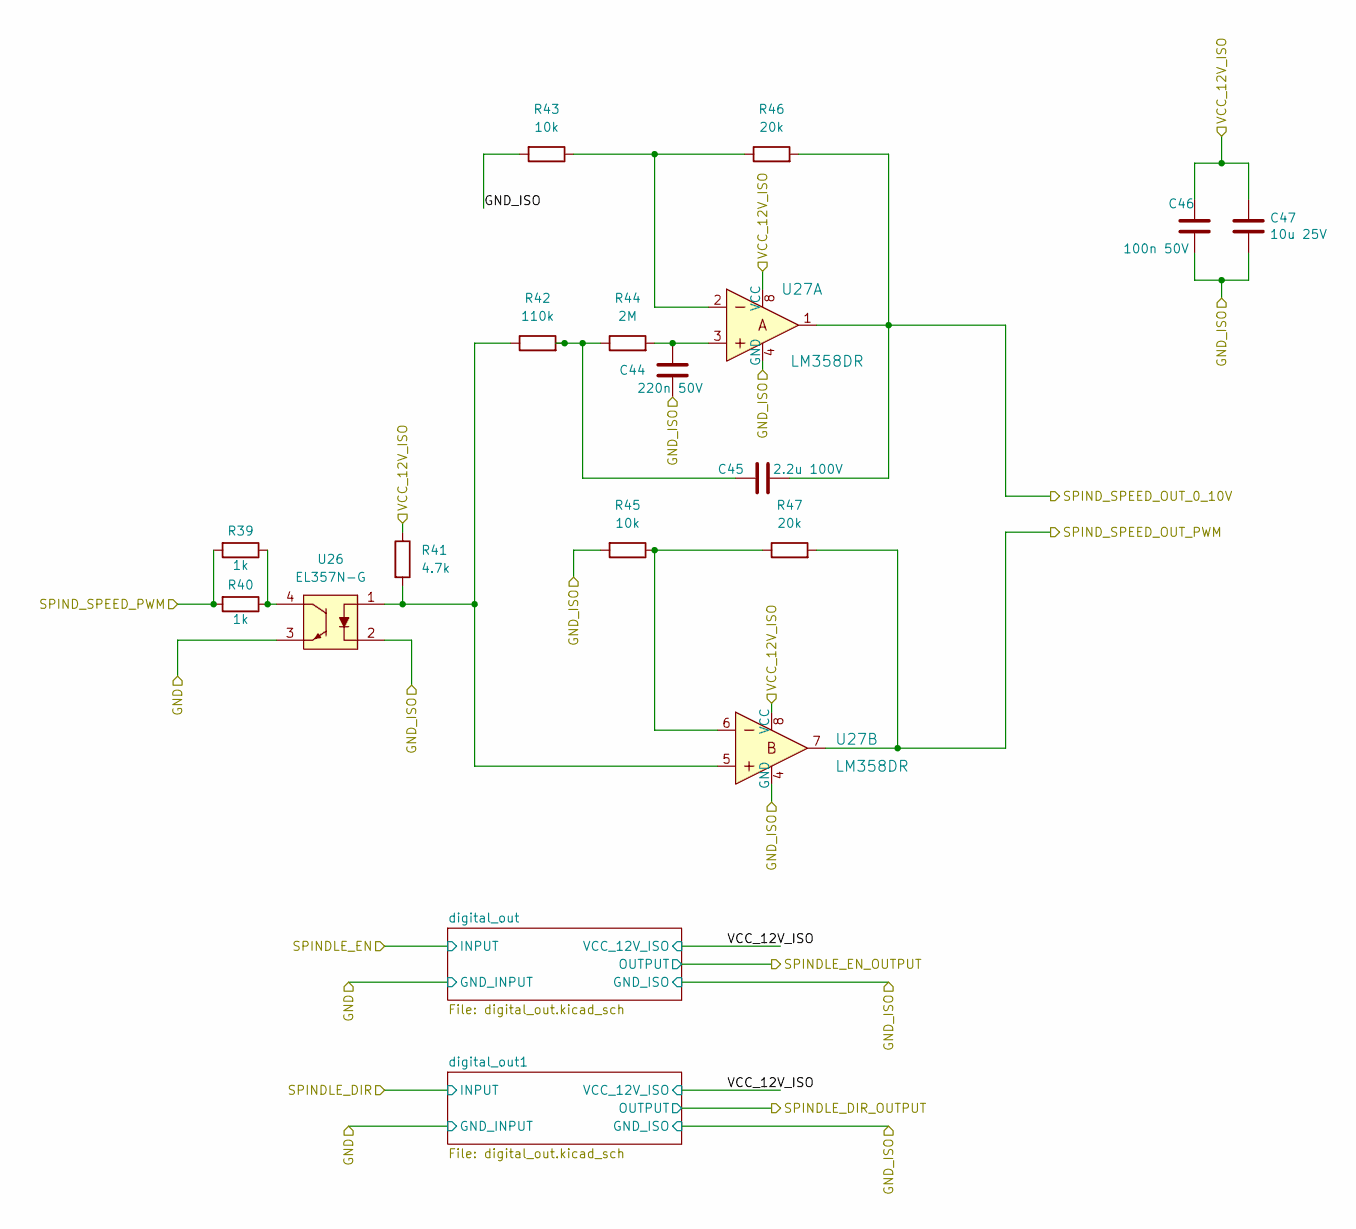
[picture p60: schematic spindle_control.kicad_sch]

Parts:
C44: 220n 50V; C_0805_2012Metric; LCSC C5378
C45: 2.2u 100V; C_1812_4532Metric; LCSC C106162
C46: 100n 50V; C_0402_1005Metric; LCSC C307331
C47: 10u 25V; C_0805_2012Metric; LCSC C15850
R39, R40: 1k; R_1206_3216Metric; LCSC C4410
R41: 4.7k; R_0805_2012Metric; LCSC C17673
R42: 110k; R_0603_1608Metric; LCSC C25805
R43, R45: 10k; R_0402_1005Metric_Pad0.72x0.64mm_HandSolder; LCSC C25744
R44: 2M; R_0603_1608Metric; LCSC C22976
R46, R47: 20k; R_0805_2012Metric; LCSC C4328
U26: EL357N-G; SOP254P700X200-4N; LCSC C29981
U27: LM358DR; SOIC-8_W3.9mm; MPN LM358DR; Digi-Key_PN 296-1014-1-ND

Connections:
GND: U26.3
GND_ISO: C44.1, C46.2, C47.2, R43.2, R45.2, U26.2, U27.4 (GND)
unnamed: C44.2, R44.2, U27.3
unnamed: C45.1, R42.2, R44.1
unnamed: R39.1, R40.1, U26.4
unnamed: R41.2, R42.1, U26.1, U27.5
unnamed: R43.1, R46.1, U27.2
unnamed: R45.1, R47.1, U27.6
SPIND_SPEED_OUT_0_10V: C45.2, R46.2, U27.1
SPIND_SPEED_OUT_PWM: R47.2, U27.7
SPIND_SPEED_PWM: R39.2, R40.2
VCC_12V_ISO: C46.1, C47.1, R41.1, U27.8 (VCC)
