lemwill/QuarkCnc/stepper_hbridge.kicad_sch

## KiCad design stepper_hbridge.kicad_sch (2022-04-29)

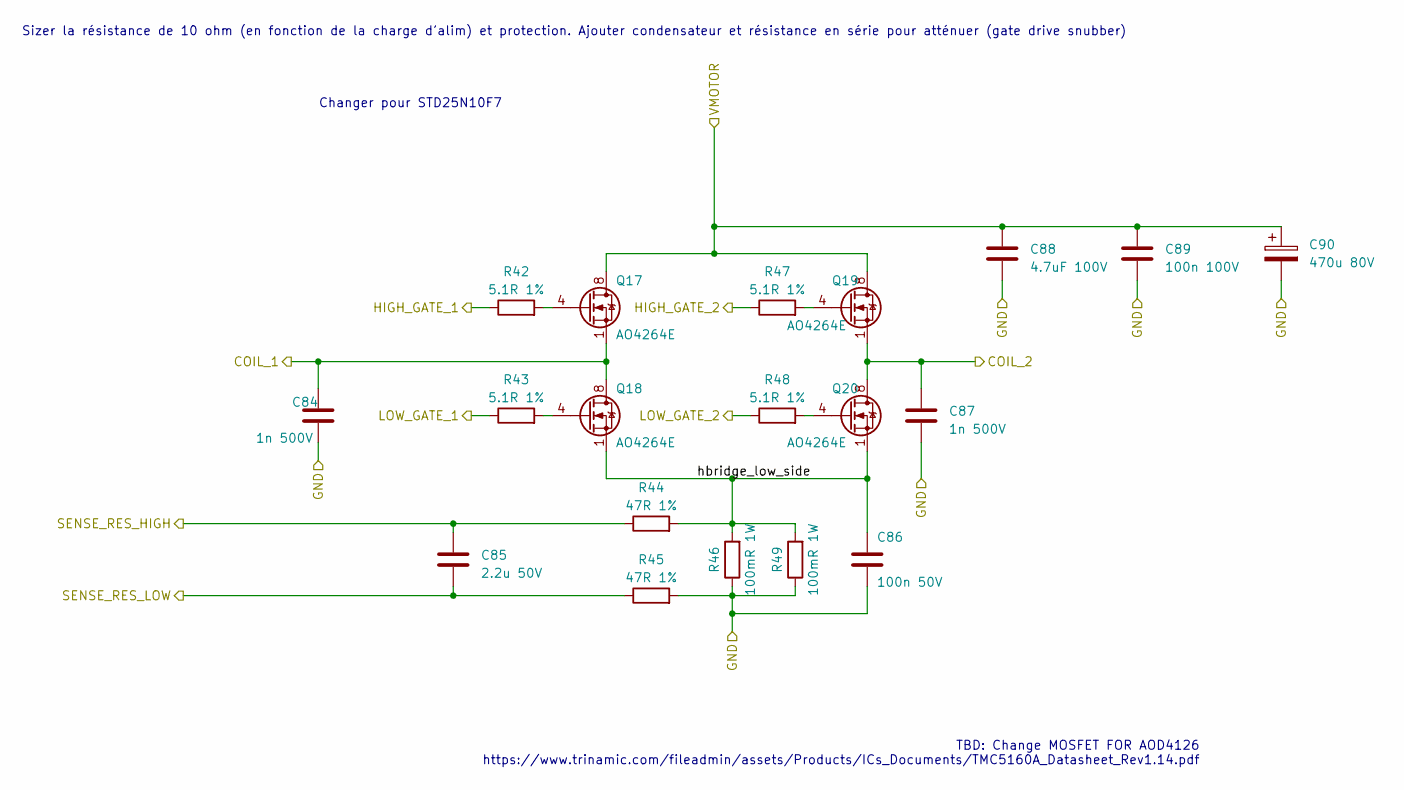
[picture p61: schematic stepper_hbridge.kicad_sch]

Parts:
C84, C87: 1n 500V; C_1206_3216Metric; LCSC C35216
C85: 2.2u 50V; C_1206_3216Metric; LCSC C50254
C86: 100n 50V; C_0402_1005Metric; LCSC C307331
C88: 4.7uF 100V; C_1206_3216Metric; LCSC C385986
C89: 100n 100V; C_0805_2012Metric_Pad1.18x1.45mm_HandSolder; LCSC C28233
C90: 470u 80V; CP_Elec_16x17.5; LCSC C487423
Q17, Q18, Q19, Q20: AO4264E; SOIC-8_3.9x4.9mm_P1.27mm; LCSC C334232
R42, R43, R47, R48: 5.1R 1%; R_0805_2012Metric; LCSC C17724
R44, R45: 47R 1%; R_0402_1005Metric; LCSC C25118
R46, R49: 100mR 1W; R_1218_3246Metric; LCSC C309639

Connections:
COIL_1: C84.1, Q17.1 (S), Q17.2 (S), Q17.3 (S), Q18.5 (D), Q18.6 (D), Q18.7 (D), Q18.8 (D)
COIL_2: C87.1, Q19.1 (S), Q19.2 (S), Q19.3 (S), Q20.5 (D), Q20.6 (D), Q20.7 (D), Q20.8 (D)
GND: C84.2, C86.2, C87.2, C88.2, C89.2, C90.2, R45.2, R46.1, R49.1
HIGH_GATE_1: R42.1
HIGH_GATE_2: R47.1
LOW_GATE_1: R43.1
LOW_GATE_2: R48.1
unnamed: Q17.4 (G), R42.2
unnamed: Q18.4 (G), R43.2
unnamed: Q19.4 (G), R47.2
unnamed: Q20.4 (G), R48.2
SENSE_RES_HIGH: C85.1, R44.1
SENSE_RES_LOW: C85.2, R45.1
VMOTOR: C88.1, C89.1, C90.1, Q17.5 (D), Q17.6 (D), Q17.7 (D), Q17.8 (D), Q19.5 (D), Q19.6 (D), Q19.7 (D), Q19.8 (D)
hbridge_low_side: C86.1, Q18.1 (S), Q18.2 (S), Q18.3 (S), Q20.1 (S), Q20.2 (S), Q20.3 (S), R44.2, R46.2, R49.2

Notes on the sheet:
TBD: Change MOSFET FOR AOD4126 https://www.trinamic.com/fileadmin/assets/Products/ICs_Documents/TMC5160A_Datasheet_Rev1.14.pdf
Sizer la résistance de 10 ohm (en fonction de la charge d'alim) et protection. Ajouter condensateur et résistance en série pour atténuer (gate drive snubber)
Changer pour STD25N10F7
