lemwill/QuarkCnc/(commit log)

2022-04-29 Added schematic pdf
2022-05-05 Refactored top sheet
    [Input_Protection.kicad_sch, Isolated supply 12V.kicad_sch, Isolated_supply_5V_15W.kicad_sch, QuarkCnc.kicad_sch, debounce.kicad_sch, digital_out.kicad_sch, emergency_stop.kicad_sch, isolated_input.kicad_sch]
